MrSwirlyEyes/transmission_of_touch_vr/code/test_scripts_unity/Hand/Assets/VR Hands/Meshes/Textures/Tex_Hands_Color.png

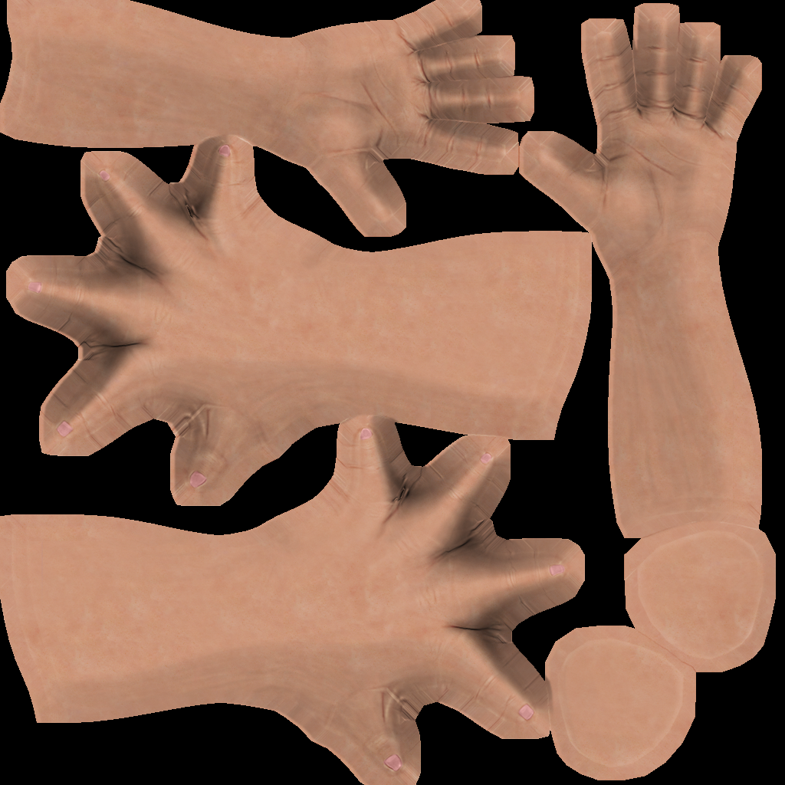
code/test_scripts_unity/Hand/Assets/VR Hands/Meshes/Textures/Tex_Hands_Color.png
