MrSwirlyEyes/transmission_of_touch_vr/doc/robotic_arm/schematic_force_sensitive_resistor_driver/schematic_force_sensitive_resistor_driver.png

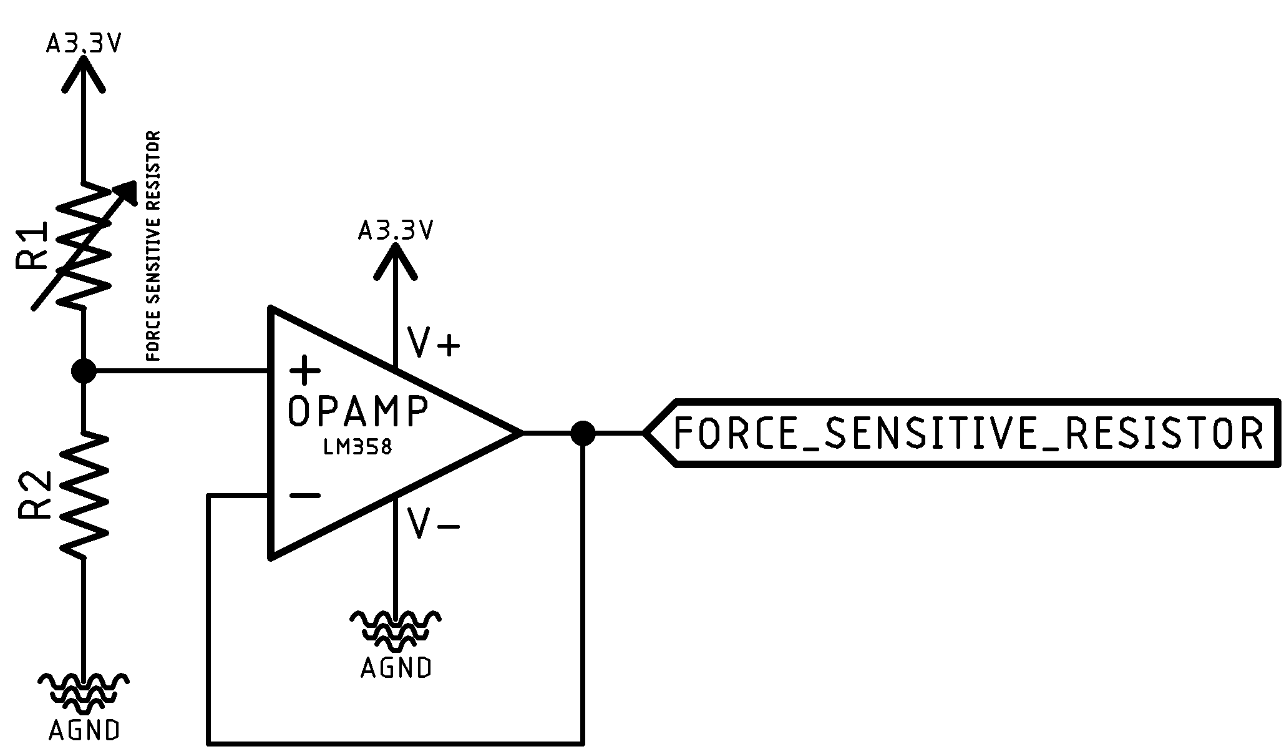
doc/robotic_arm/schematic_force_sensitive_resistor_driver/schematic_force_sensitive_resistor_driver.png
