MrSwirlyEyes/transmission_of_touch_vr/doc/robotic_arm/schematic_servo_driver/schematic_servo_driver.png

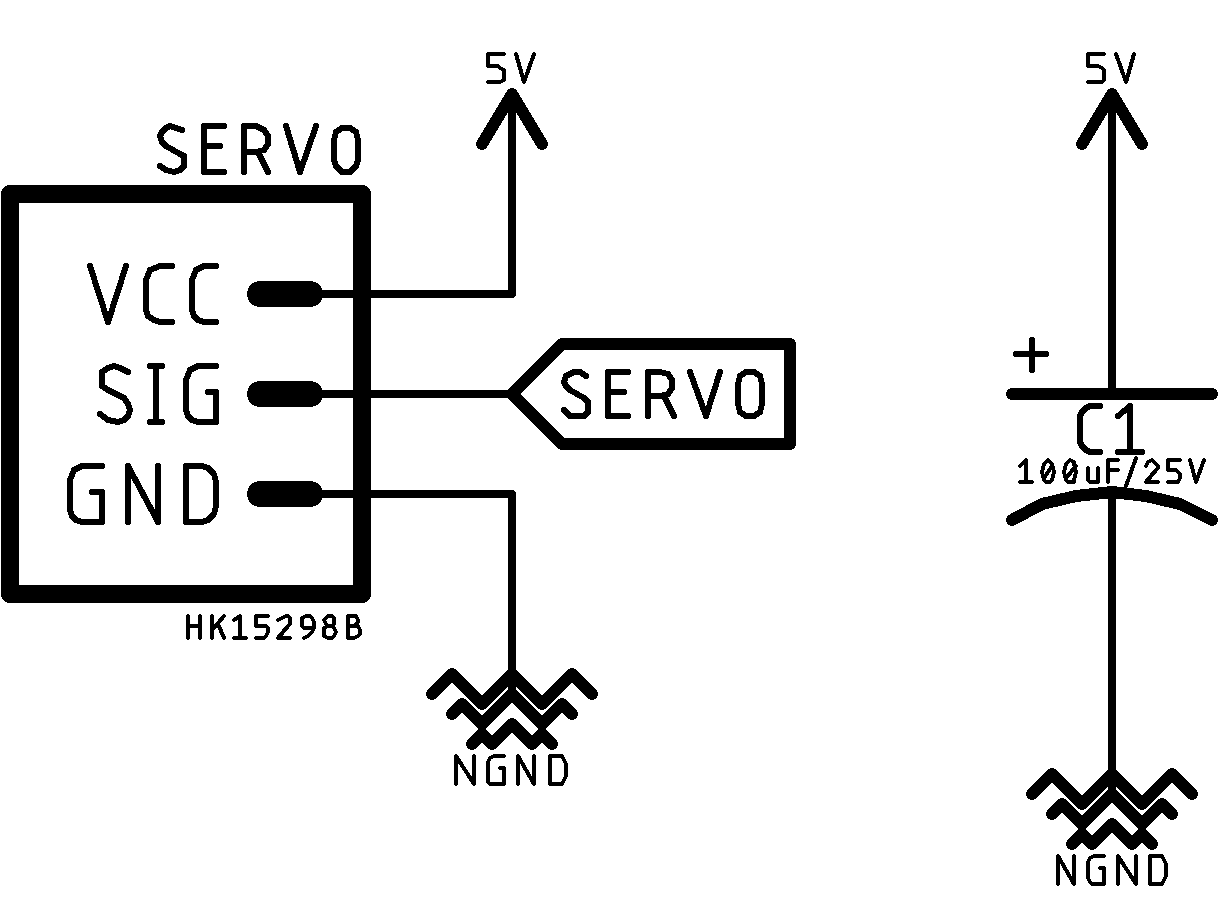
doc/robotic_arm/schematic_servo_driver/schematic_servo_driver.png
