MrSwirlyEyes/transmission_of_touch_vr/doc/robotic_arm/schematic_temperature_sensor_driver/schematic_temperature_sensor_driver.png

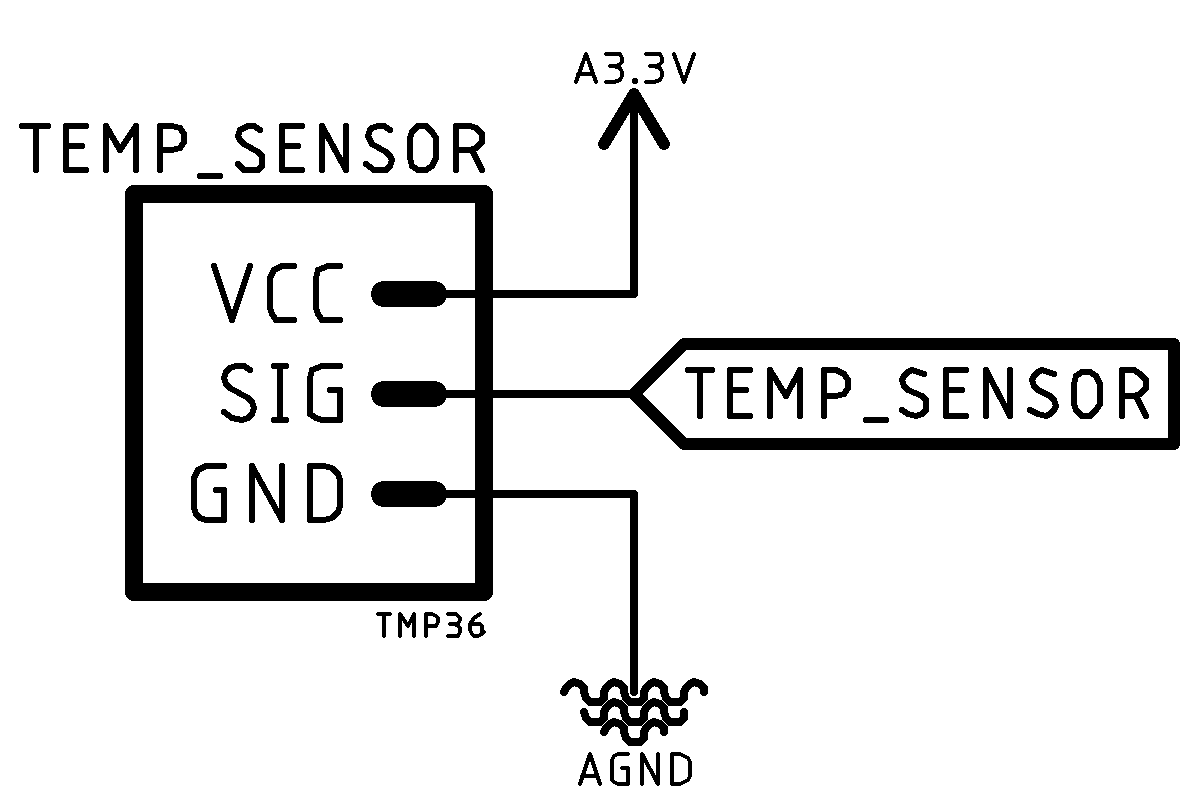
doc/robotic_arm/schematic_temperature_sensor_driver/schematic_temperature_sensor_driver.png
