MrSwirlyEyes/transmission_of_touch_vr/doc/touch_glove/schematic_flex_sensor_driver/schematic_flex_sensor_driver.png

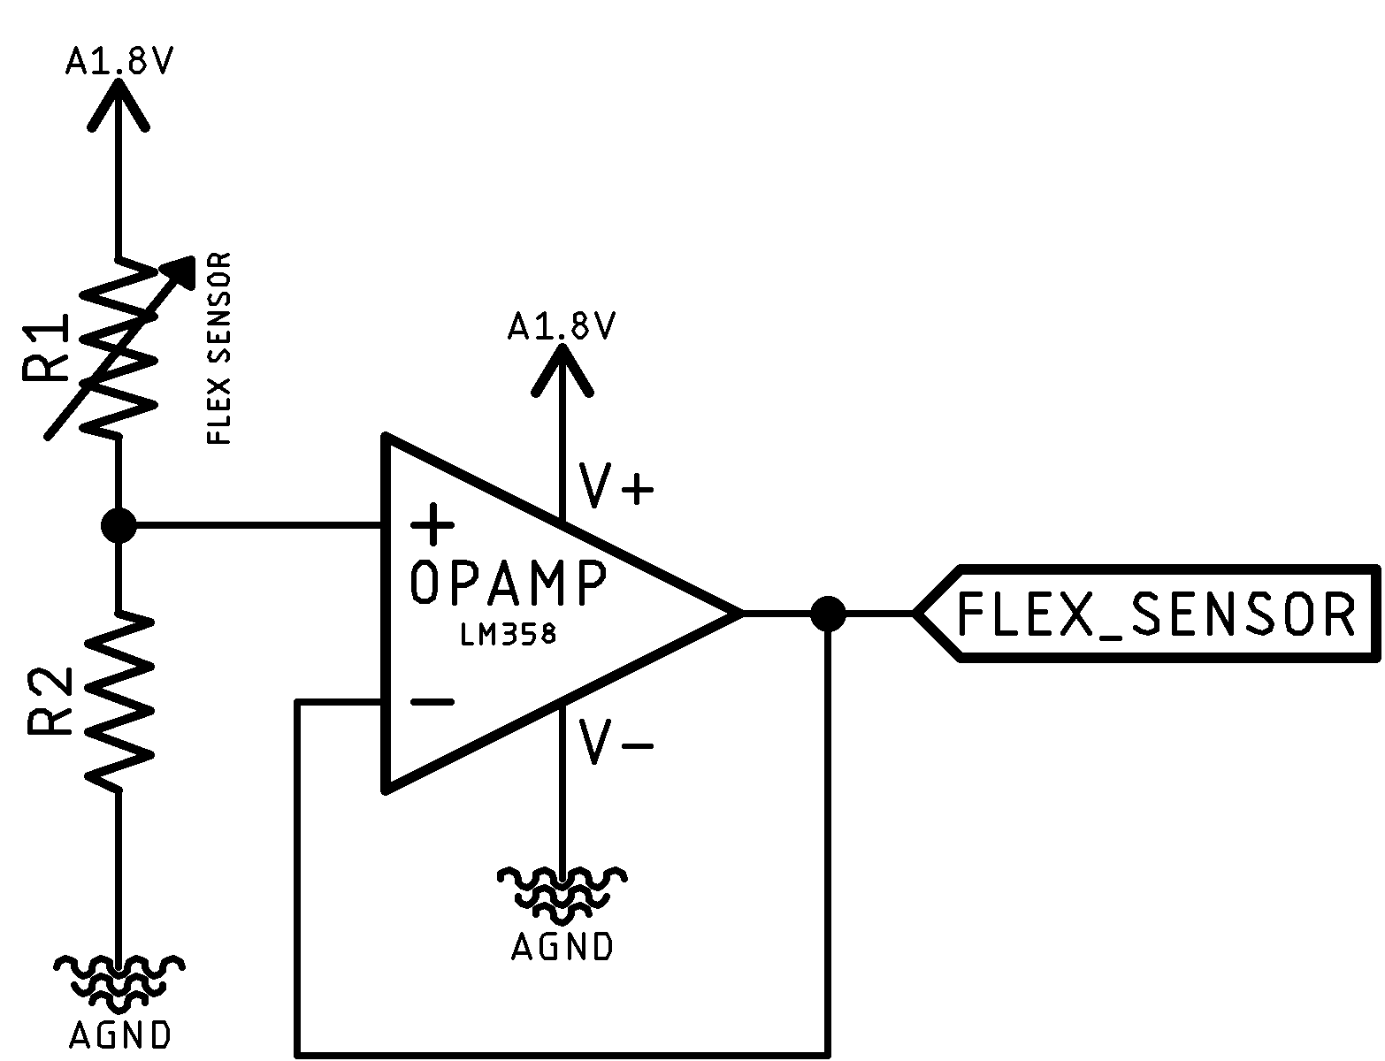
doc/touch_glove/schematic_flex_sensor_driver/schematic_flex_sensor_driver.png
