MrSwirlyEyes/transmission_of_touch_vr/doc/touch_glove/schematic_square_wave_oscillator/schematic_square_wave_oscillator.png

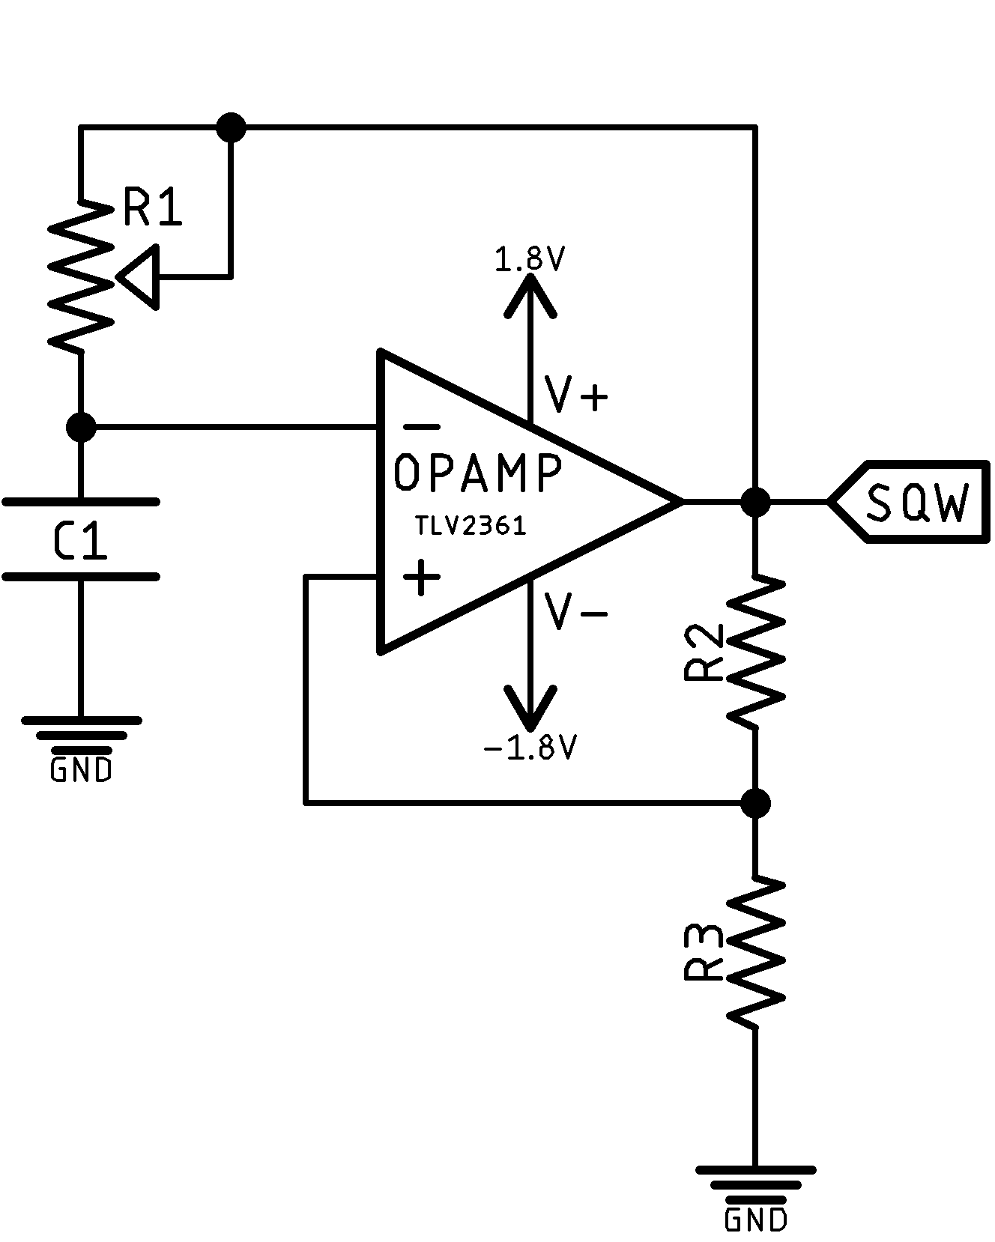
doc/touch_glove/schematic_square_wave_oscillator/schematic_square_wave_oscillator.png
