MrSwirlyEyes/transmission_of_touch_vr/doc/touch_glove/schematic_thermoelectric_driver/schematic_thermoelectric_driver.png

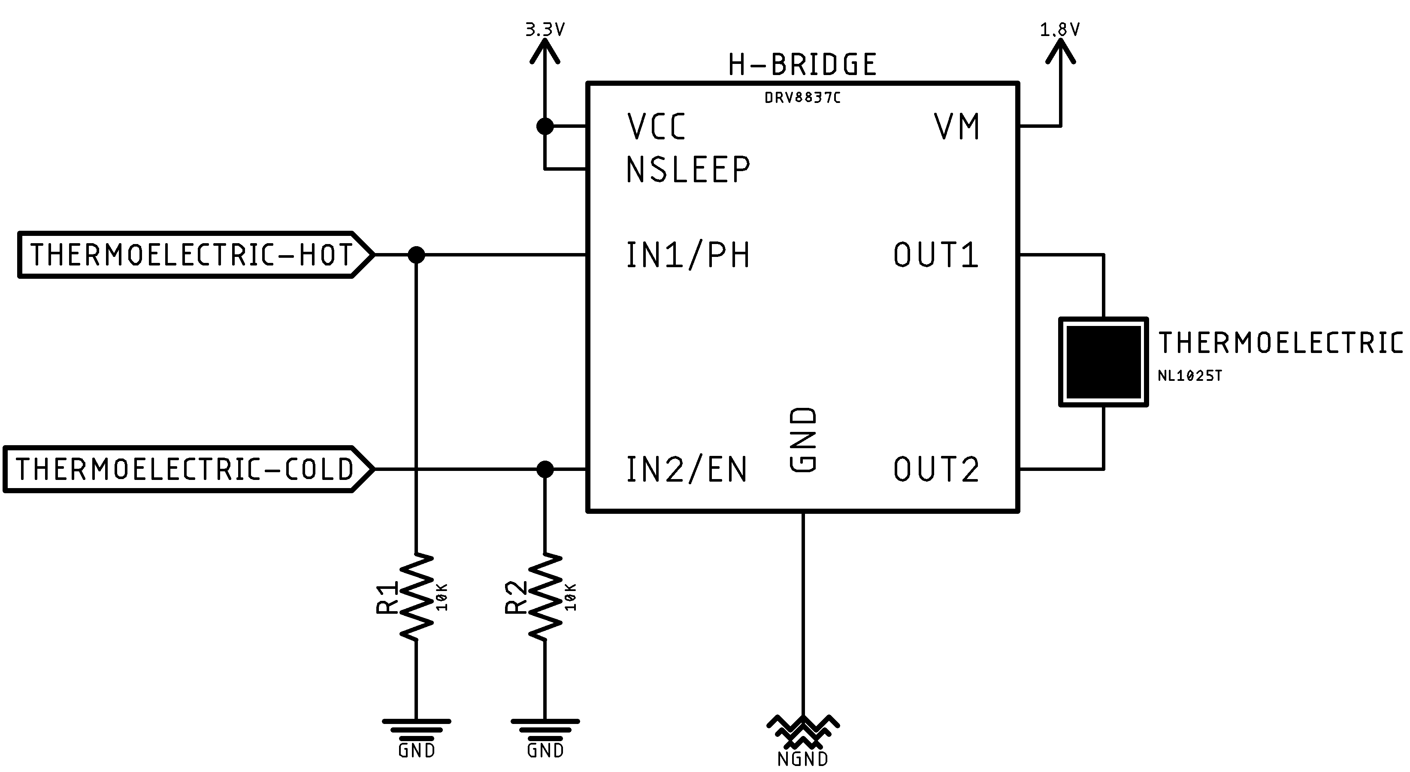
doc/touch_glove/schematic_thermoelectric_driver/schematic_thermoelectric_driver.png
