MrSwirlyEyes/transmission_of_touch_vr/doc/touch_glove/schematic_vibrotactile_driver/schematic_vibrotactile_driver.png

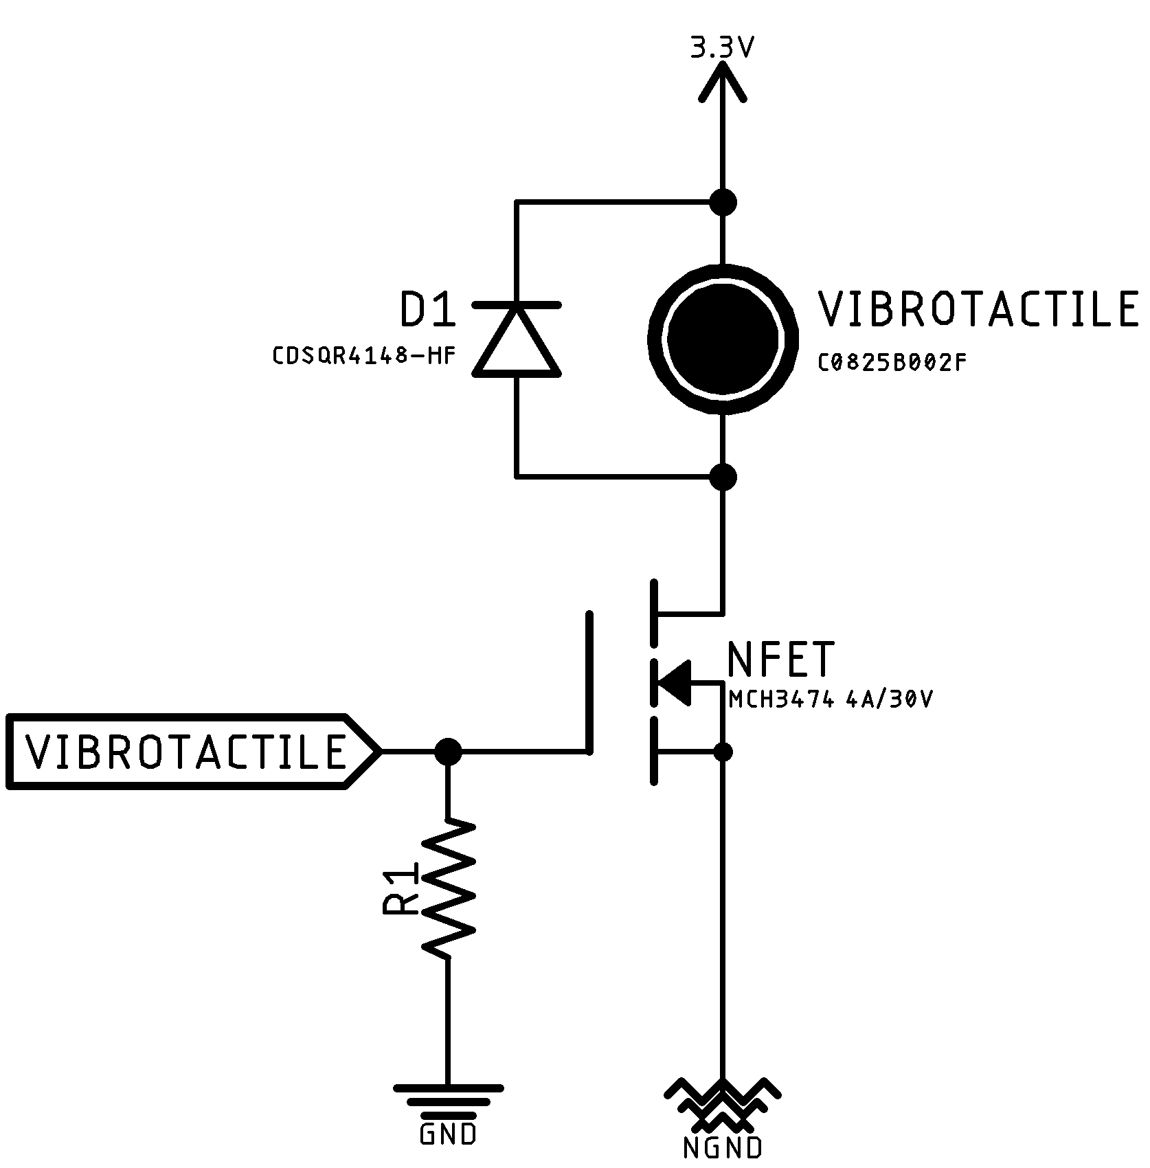
doc/touch_glove/schematic_vibrotactile_driver/schematic_vibrotactile_driver.png
