MrSwirlyEyes/transmission_of_touch_vr/ecad/electrotactile_extension/electrotactile_extension.brd

## EAGLE design ecad/electrotactile_extension/electrotactile_extension.brd (2019-05-16)

Schematic: electrotactile_extension.sch

Parts:
C37, C49, C63, C64, C66, C68, C69, C70, C76, C78, C80: 0.1uF/50V; CAPC1005X55_SMD-0402
C61: 0.1uF/50V; CAPC1608X95
C62: 0.1uF/250V/0805; CAPC2012X95_SMD-0805
C65: 100uF/10V; CAPCP3216X160
C71, C72, C73, C75, C77, C79: 10uF/6.3V; CAPC1005X55_SMD-0402
C74: 4.7uF/10V/0402; CAPC1005X55_SMD-0402
ET_INDEX_PIXEL1-1, ET_INDEX_PIXEL1-2, ET_INDEX_PIXEL1-3, ET_INDEX_PIXEL1-4, ET_INDEX_PIXEL2-1, ET_INDEX_PIXEL2-2, ET_INDEX_PIXEL2-3, ET_INDEX_PIXEL2-4, ET_INDEX_PIXEL3-1, ET_INDEX_PIXEL3-2, ET_INDEX_PIXEL3-3, ET_INDEX_PIXEL3-4, ET_INDEX_PIXEL4-1, ET_INDEX_PIXEL4-2, ET_INDEX_PIXEL4-3, ET_INDEX_PIXEL4-4: SPST-NO 170mA 250V; SOP254P609X203-4
ET_MIDDLE_PIXEL1-1, ET_MIDDLE_PIXEL1-2, ET_MIDDLE_PIXEL1-3, ET_MIDDLE_PIXEL1-4, ET_MIDDLE_PIXEL2-1, ET_MIDDLE_PIXEL2-2, ET_MIDDLE_PIXEL2-3, ET_MIDDLE_PIXEL2-4, ET_MIDDLE_PIXEL3-1, ET_MIDDLE_PIXEL3-2, ET_MIDDLE_PIXEL3-3, ET_MIDDLE_PIXEL3-4, ET_MIDDLE_PIXEL4-1, ET_MIDDLE_PIXEL4-2, ET_MIDDLE_PIXEL4-3, ET_MIDDLE_PIXEL4-4: SPST-NO 170mA 250V; SOP254P609X203-4
ET_PINKY_PIXEL1-1, ET_PINKY_PIXEL1-2, ET_PINKY_PIXEL1-3, ET_PINKY_PIXEL1-4, ET_PINKY_PIXEL2-1, ET_PINKY_PIXEL2-2, ET_PINKY_PIXEL2-3, ET_PINKY_PIXEL2-4, ET_PINKY_PIXEL3-1, ET_PINKY_PIXEL3-2, ET_PINKY_PIXEL3-3, ET_PINKY_PIXEL3-4, ET_PINKY_PIXEL4-1, ET_PINKY_PIXEL4-2, ET_PINKY_PIXEL4-3, ET_PINKY_PIXEL4-4: SPST-NO 170mA 250V; SOP254P609X203-4
ET_RING_PIXEL1-1, ET_RING_PIXEL1-2, ET_RING_PIXEL1-3, ET_RING_PIXEL1-4, ET_RING_PIXEL2-1, ET_RING_PIXEL2-2, ET_RING_PIXEL2-3, ET_RING_PIXEL2-4, ET_RING_PIXEL3-1, ET_RING_PIXEL3-2, ET_RING_PIXEL3-3, ET_RING_PIXEL3-4, ET_RING_PIXEL4-1, ET_RING_PIXEL4-2, ET_RING_PIXEL4-3, ET_RING_PIXEL4-4: SPST-NO 170mA 250V; SOP254P609X203-4
IC1: DRV8662; QFN50P400X400X100-21T270
INDEX_CONNECTOR: 1x17 MOLEX SMD RA; 1X17_MOLEX_0532611771_RA_SMD
J6, J7, J8, J9: 1x02 PTH VERT FEMALE; HDRVR2W64P254_1X2_558X254X850B
L3: 4.7uH/2A/1008; INDC2520X100
L4: 10uH/380mA; INDC1608X60-0603
MIDDLE_CONNECTOR: 1x17 MOLEX SMD RA; 1X17_MOLEX_0532611771_RA_SMD
MUX_INDEX: PCA9685; SOP65P650X110-28
MUX_MIDDLE: PCA9685; SOP65P650X110-28
MUX_PINKY: PCA9685; SOP65P650X110-28
MUX_RING: PCA9685; SOP65P650X110-28
NFET1: 2N7002DW; SOT65P230X110-6
OPAMP4: TLV2361_GP_20MA_7MHZ; SOT95P280X145-5
PINKY_CONNECTOR: 1x17 MOLEX SMD RA; 1X17_MOLEX_0532611771_RA_SMD
POT1: 100K; POTENTIOMETER_SQ-L5-W4.5-H2.3
R1: 768K; RESC1005X35_SMD-0402
R2: 115K; RESC1005X35_SMD-0402
R4: 220K; RESC1005X35_SMD-0402
R5: 100K; RESC1005X35_SMD-0402
R49, R57, R58, R59, R60, R61, R62, R63, R64, R65, R66, R67, R68, R69, R70, R71, R88, R89, R90, R91, R92, R93, R94, R95, R96, R97, R98, R99, R100, R101, R102, R103, R104, R105, R106, R107, R108, R109, R110, R111, R112, R113, R114, R115, R116, R117, R118, R119, R120, R121, R122, R123, R124, R125, R126, R127, R128, R129, R130, R131, R132, R133, R134, R135: 1K; RESC1005X35_SMD-0402
R54, R55, R56, R136, R137: 10K; RESC1005X35_SMD-0402
REXT: 7.5K; RESC1005X35_SMD-0402
RING_CONNECTOR: 1x17 MOLEX SMD RA; 1X17_MOLEX_0532611771_RA_SMD
SW1, SW3, SW4: 300mA/4V; SW_SLIDE_SPDT_RA_SMD_4V_300MA_6.7L-2.6W
VREG2: NCP1729 50mA; SOT95P275X100-6
VREG3: TPS62202 300mA 1.8V; SOT95P280X145-5
VREG-MCU1: TPS76833QDR 1A/3.3V; SOIC127P600X265-8

Connections:
1.8V: C73.1, C75.1, L4.2, OPAMP4.5 (V+), VREG2.2 (VIN), VREG2.5 (!SHDN), VREG3.4 (NC/FB)
3.3V: C37.1, C61.1, C65.A, C66.1, C68.1, C69.1, C70.1, C74.1, C77.1, C78.1, IC1.2 (VDD), L3.2, MUX_INDEX.2 (A1), MUX_INDEX.28 (VCC), MUX_MIDDLE.1 (A0), MUX_MIDDLE.2 (A1), MUX_MIDDLE.28 (VCC), MUX_PINKY.1 (A0), MUX_PINKY.3 (A2), MUX_PINKY.28 (VCC), MUX_RING.3 (A2), MUX_RING.28 (VCC), SW1.2, SW3.2, SW4.2, VREG3.1 (VIN), VREG3.3 (EN), VREG-MCU1.5 (VOUT), VREG-MCU1.6 (VOUT)
-1.8V: C72.1, OPAMP4.2 (V-), VREG2.1 (VOUT)
C+: C71.1, VREG2.6 (C+)
C-: C71.2, VREG2.3 (C-)
EN: IC1.20 (EN), R54.2, SW1.3 (S2)
FB: IC1.3 (FB), R1.1, R2.2, R4.2, R5.2
GAIN0: IC1.18 (GAIN0), NFET1.5 (G2), R55.2, SW3.3 (S2)
GAIN1: IC1.19 (GAIN1), NFET1.2 (G1), R56.2, SW4.3 (S2)
GND: C37.2, C49.2, C61.2, C62.2, C63.1, C65.K, C66.2, C68.2, C69.2, C70.2, C72.2, C73.2, C74.2, C75.2, C76.2, C77.2, C78.2, C79.2, C80.2, IC1.4 (GND), IC1.5 (GND), IC1.6 (GND), IC1.9 (GND), IC1.EP (GND), IC1.P$1 (GND), IC1.P$2 (GND), IC1.P$3 (GND), IC1.P$4 (GND), J6.2, MUX_INDEX.1 (A0), MUX_INDEX.3 (A2), MUX_INDEX.4 (A3), MUX_INDEX.5 (A4), MUX_INDEX.14 (GND), MUX_INDEX.23 (!OE), MUX_INDEX.24 (A5), MUX_INDEX.25 (EXTCLK), MUX_MIDDLE.3 (A2), MUX_MIDDLE.4 (A3), MUX_MIDDLE.5 (A4), MUX_MIDDLE.14 (GND), MUX_MIDDLE.23 (!OE), MUX_MIDDLE.24 (A5), MUX_MIDDLE.25 (EXTCLK), MUX_PINKY.2 (A1), MUX_PINKY.4 (A3), MUX_PINKY.5 (A4), MUX_PINKY.14 (GND), MUX_PINKY.23 (!OE), MUX_PINKY.24 (A5), MUX_PINKY.25 (EXTCLK), MUX_RING.1 (A0), MUX_RING.2 (A1), MUX_RING.4 (A3), MUX_RING.5 (A4), MUX_RING.14 (GND), MUX_RING.23 (!OE), MUX_RING.24 (A5), MUX_RING.25 (EXTCLK), NFET1.1 (S1), NFET1.4 (S2), R2.1, R49.1, R54.1, R55.1, R56.1, R57.1, R58.1, R59.1, R60.1, R61.1, R62.1, R63.1, R64.1, R65.1, R66.1, R67.1, R68.1, R69.1, R70.1, R71.1, R88.1, R89.1, R90.1, R91.1, R92.1, R93.1, R94.1, R95.1, R96.1, R97.1, R98.1, R99.1, R100.1, R101.1, R102.1, R103.1, R104.1, R105.1, R106.1, R107.1, R108.1, R109.1, R110.1, R111.1, R112.1, R113.1, R114.1, R115.1, R116.1, R117.1, R118.1, R119.1, R120.1, R121.1, R122.1, R123.1, R124.1, R125.1, R126.1, R127.1, R128.1, R129.1, R130.1, R131.1, R132.1, R133.1, R134.1, R135.1, R137.1, REXT.1, VREG2.4 (GND), VREG3.2 (GND), VREG-MCU1.1 (GND), VREG-MCU1.2 (!EN)
IN+: C64.1, OPAMP4.4 (OUT), POT1.1 (CCW), POT1.2 (S), R136.2
INDEX_IN1-1: ET_INDEX_PIXEL1-1.1, MUX_INDEX.6 (PWM0)
INDEX_IN1-2: ET_INDEX_PIXEL1-2.1, MUX_INDEX.8 (PWM2)
INDEX_IN1-3: ET_INDEX_PIXEL1-3.1, MUX_INDEX.10 (PWM4)
INDEX_IN1-4: ET_INDEX_PIXEL1-4.1, MUX_INDEX.12 (PWM6)
INDEX_IN2-1: ET_INDEX_PIXEL2-1.1, MUX_INDEX.7 (PWM1)
INDEX_IN2-2: ET_INDEX_PIXEL2-2.1, MUX_INDEX.9 (PWM3)
INDEX_IN2-3: ET_INDEX_PIXEL2-3.1, MUX_INDEX.11 (PWM5)
INDEX_IN2-4: ET_INDEX_PIXEL2-4.1, MUX_INDEX.13 (PWM7)
INDEX_IN3-1: ET_INDEX_PIXEL3-1.1, MUX_INDEX.15 (PWM8)
INDEX_IN3-2: ET_INDEX_PIXEL3-2.1, MUX_INDEX.17 (PWM10)
INDEX_IN3-3: ET_INDEX_PIXEL3-3.1, MUX_INDEX.19 (PWM12)
INDEX_IN3-4: ET_INDEX_PIXEL3-4.1, MUX_INDEX.21 (PWM14)
INDEX_IN4-1: ET_INDEX_PIXEL4-1.1, MUX_INDEX.16 (PWM9)
INDEX_IN4-2: ET_INDEX_PIXEL4-2.1, MUX_INDEX.18 (PWM11)
INDEX_IN4-3: ET_INDEX_PIXEL4-3.1, MUX_INDEX.20 (PWM13)
INDEX_IN4-4: ET_INDEX_PIXEL4-4.1, MUX_INDEX.22 (PWM15)
INDEX_OUT1-1: ET_INDEX_PIXEL1-1.3, INDEX_CONNECTOR.1
INDEX_OUT1-2: ET_INDEX_PIXEL1-2.3, INDEX_CONNECTOR.3
INDEX_OUT1-3: ET_INDEX_PIXEL1-3.3, INDEX_CONNECTOR.5
INDEX_OUT1-4: ET_INDEX_PIXEL1-4.3, INDEX_CONNECTOR.7
INDEX_OUT2-1: ET_INDEX_PIXEL2-1.3, INDEX_CONNECTOR.2
INDEX_OUT2-2: ET_INDEX_PIXEL2-2.3, INDEX_CONNECTOR.4
INDEX_OUT2-3: ET_INDEX_PIXEL2-3.3, INDEX_CONNECTOR.6
INDEX_OUT2-4: ET_INDEX_PIXEL2-4.3, INDEX_CONNECTOR.8
INDEX_OUT3-1: ET_INDEX_PIXEL3-1.3, INDEX_CONNECTOR.9
INDEX_OUT3-2: ET_INDEX_PIXEL3-2.3, INDEX_CONNECTOR.11
INDEX_OUT3-3: ET_INDEX_PIXEL3-3.3, INDEX_CONNECTOR.13
INDEX_OUT3-4: ET_INDEX_PIXEL3-4.3, INDEX_CONNECTOR.15
INDEX_OUT4-1: ET_INDEX_PIXEL4-1.3, INDEX_CONNECTOR.10
INDEX_OUT4-2: ET_INDEX_PIXEL4-2.3, INDEX_CONNECTOR.12
INDEX_OUT4-3: ET_INDEX_PIXEL4-3.3, INDEX_CONNECTOR.14
INDEX_OUT4-4: ET_INDEX_PIXEL4-4.3, INDEX_CONNECTOR.16
MIDDLE_IN1-1: ET_MIDDLE_PIXEL1-1.1, MUX_MIDDLE.21 (PWM14)
MIDDLE_IN1-2: ET_MIDDLE_PIXEL1-2.1, MUX_MIDDLE.19 (PWM12)
MIDDLE_IN1-3: ET_MIDDLE_PIXEL1-3.1, MUX_MIDDLE.17 (PWM10)
MIDDLE_IN1-4: ET_MIDDLE_PIXEL1-4.1, MUX_MIDDLE.15 (PWM8)
MIDDLE_IN2-1: ET_MIDDLE_PIXEL2-1.1, MUX_MIDDLE.22 (PWM15)
MIDDLE_IN2-2: ET_MIDDLE_PIXEL2-2.1, MUX_MIDDLE.20 (PWM13)
MIDDLE_IN2-3: ET_MIDDLE_PIXEL2-3.1, MUX_MIDDLE.18 (PWM11)
MIDDLE_IN2-4: ET_MIDDLE_PIXEL2-4.1, MUX_MIDDLE.16 (PWM9)
MIDDLE_IN3-1: ET_MIDDLE_PIXEL3-1.1, MUX_MIDDLE.12 (PWM6)
MIDDLE_IN3-2: ET_MIDDLE_PIXEL3-2.1, MUX_MIDDLE.10 (PWM4)
MIDDLE_IN3-3: ET_MIDDLE_PIXEL3-3.1, MUX_MIDDLE.8 (PWM2)
MIDDLE_IN3-4: ET_MIDDLE_PIXEL3-4.1, MUX_MIDDLE.6 (PWM0)
MIDDLE_IN4-1: ET_MIDDLE_PIXEL4-1.1, MUX_MIDDLE.13 (PWM7)
MIDDLE_IN4-2: ET_MIDDLE_PIXEL4-2.1, MUX_MIDDLE.11 (PWM5)
MIDDLE_IN4-3: ET_MIDDLE_PIXEL4-3.1, MUX_MIDDLE.9 (PWM3)
MIDDLE_IN4-4: ET_MIDDLE_PIXEL4-4.1, MUX_MIDDLE.7 (PWM1)
MIDDLE_OUT1-1: ET_MIDDLE_PIXEL1-1.3, MIDDLE_CONNECTOR.16
MIDDLE_OUT1-2: ET_MIDDLE_PIXEL1-2.3, MIDDLE_CONNECTOR.14
MIDDLE_OUT1-3: ET_MIDDLE_PIXEL1-3.3, MIDDLE_CONNECTOR.12
MIDDLE_OUT1-4: ET_MIDDLE_PIXEL1-4.3, MIDDLE_CONNECTOR.10
MIDDLE_OUT2-1: ET_MIDDLE_PIXEL2-1.3, MIDDLE_CONNECTOR.17
MIDDLE_OUT2-2: ET_MIDDLE_PIXEL2-2.3, MIDDLE_CONNECTOR.15
MIDDLE_OUT2-3: ET_MIDDLE_PIXEL2-3.3, MIDDLE_CONNECTOR.13
MIDDLE_OUT2-4: ET_MIDDLE_PIXEL2-4.3, MIDDLE_CONNECTOR.11
MIDDLE_OUT3-1: ET_MIDDLE_PIXEL3-1.3, MIDDLE_CONNECTOR.8
MIDDLE_OUT3-2: ET_MIDDLE_PIXEL3-2.3, MIDDLE_CONNECTOR.6
MIDDLE_OUT3-3: ET_MIDDLE_PIXEL3-3.3, MIDDLE_CONNECTOR.4
MIDDLE_OUT3-4: ET_MIDDLE_PIXEL3-4.3, MIDDLE_CONNECTOR.2
MIDDLE_OUT4-1: ET_MIDDLE_PIXEL4-1.3, MIDDLE_CONNECTOR.9
MIDDLE_OUT4-2: ET_MIDDLE_PIXEL4-2.3, MIDDLE_CONNECTOR.7
MIDDLE_OUT4-3: ET_MIDDLE_PIXEL4-3.3, MIDDLE_CONNECTOR.5
MIDDLE_OUT4-4: ET_MIDDLE_PIXEL4-4.3, MIDDLE_CONNECTOR.3
unnamed: ET_INDEX_PIXEL1-3.2, R58.2
unnamed: ET_INDEX_PIXEL1-1.2, R49.2
unnamed: IC1.7 (SW), IC1.8 (SW), L3.1
unnamed: C49.1, IC1.1 (VPUMP)
unnamed: C62.1, IC1.10 (VBST), IC1.11 (VBST), IC1.12 (PVDD), R1.2
unnamed: IC1.15 (REXT), REXT.2
unnamed: NFET1.6 (D1), R4.1
unnamed: NFET1.3 (D2), R5.1
unnamed: C64.2, IC1.17 (IN+)
unnamed: C63.2, IC1.16 (IN-)
unnamed: ET_INDEX_PIXEL1-2.2, R57.2
unnamed: ET_INDEX_PIXEL1-4.2, R59.2
unnamed: ET_INDEX_PIXEL2-1.2, R60.2
unnamed: ET_INDEX_PIXEL2-2.2, R61.2
unnamed: ET_INDEX_PIXEL2-3.2, R62.2
unnamed: ET_INDEX_PIXEL2-4.2, R63.2
unnamed: ET_INDEX_PIXEL3-1.2, R64.2
unnamed: ET_INDEX_PIXEL3-2.2, R65.2
unnamed: ET_INDEX_PIXEL3-3.2, R66.2
unnamed: ET_INDEX_PIXEL3-4.2, R67.2
unnamed: ET_INDEX_PIXEL4-1.2, R68.2
unnamed: ET_INDEX_PIXEL4-2.2, R69.2
unnamed: ET_INDEX_PIXEL4-3.2, R70.2
unnamed: ET_INDEX_PIXEL4-4.2, R71.2
unnamed: ET_MIDDLE_PIXEL1-1.2, R88.2
unnamed: ET_MIDDLE_PIXEL1-2.2, R89.2
unnamed: ET_MIDDLE_PIXEL1-3.2, R90.2
unnamed: ET_MIDDLE_PIXEL1-4.2, R91.2
unnamed: ET_MIDDLE_PIXEL2-1.2, R92.2
unnamed: ET_MIDDLE_PIXEL2-2.2, R93.2
unnamed: ET_MIDDLE_PIXEL2-3.2, R94.2
unnamed: ET_MIDDLE_PIXEL2-4.2, R95.2
unnamed: ET_MIDDLE_PIXEL3-1.2, R96.2
unnamed: ET_MIDDLE_PIXEL3-2.2, R97.2
unnamed: ET_MIDDLE_PIXEL3-3.2, R98.2
unnamed: ET_MIDDLE_PIXEL3-4.2, R99.2
unnamed: ET_MIDDLE_PIXEL4-1.2, R100.2
unnamed: ET_MIDDLE_PIXEL4-2.2, R101.2
unnamed: ET_MIDDLE_PIXEL4-3.2, R102.2
unnamed: ET_MIDDLE_PIXEL4-4.2, R103.2
unnamed: ET_RING_PIXEL1-1.2, R104.2
unnamed: ET_RING_PIXEL1-2.2, R105.2
unnamed: ET_RING_PIXEL1-3.2, R106.2
unnamed: ET_RING_PIXEL1-4.2, R107.2
unnamed: ET_RING_PIXEL2-1.2, R108.2
unnamed: ET_RING_PIXEL2-2.2, R109.2
unnamed: ET_RING_PIXEL2-3.2, R110.2
unnamed: ET_RING_PIXEL2-4.2, R111.2
unnamed: ET_RING_PIXEL3-1.2, R112.2
unnamed: ET_RING_PIXEL3-2.2, R113.2
unnamed: ET_RING_PIXEL3-3.2, R114.2
unnamed: ET_RING_PIXEL3-4.2, R115.2
unnamed: ET_RING_PIXEL4-1.2, R116.2
unnamed: ET_RING_PIXEL4-2.2, R117.2
unnamed: ET_RING_PIXEL4-3.2, R118.2
unnamed: ET_RING_PIXEL4-4.2, R119.2
unnamed: ET_PINKY_PIXEL1-1.2, R120.2
unnamed: ET_PINKY_PIXEL1-2.2, R121.2
unnamed: ET_PINKY_PIXEL1-3.2, R122.2
unnamed: ET_PINKY_PIXEL1-4.2, R123.2
unnamed: ET_PINKY_PIXEL2-1.2, R124.2
unnamed: ET_PINKY_PIXEL2-2.2, R125.2
unnamed: ET_PINKY_PIXEL2-3.2, R126.2
unnamed: ET_PINKY_PIXEL2-4.2, R127.2
unnamed: ET_PINKY_PIXEL3-1.2, R128.2
unnamed: ET_PINKY_PIXEL3-2.2, R129.2
unnamed: ET_PINKY_PIXEL3-3.2, R130.2
unnamed: ET_PINKY_PIXEL3-4.2, R131.2
unnamed: ET_PINKY_PIXEL4-1.2, R132.2
unnamed: ET_PINKY_PIXEL4-2.2, R133.2
unnamed: ET_PINKY_PIXEL4-3.2, R134.2
unnamed: ET_PINKY_PIXEL4-4.2, R135.2
unnamed: L4.1, VREG3.5 (VOUT)
unnamed: OPAMP4.1 (IN+), R136.1, R137.2
unnamed: C76.1, OPAMP4.3 (IN-), POT1.3 (CW)
PINKY_IN1-1: ET_PINKY_PIXEL1-1.1, MUX_PINKY.22 (PWM15)
PINKY_IN1-2: ET_PINKY_PIXEL1-2.1, MUX_PINKY.20 (PWM13)
PINKY_IN1-3: ET_PINKY_PIXEL1-3.1, MUX_PINKY.18 (PWM11)
PINKY_IN1-4: ET_PINKY_PIXEL1-4.1, MUX_PINKY.16 (PWM9)
PINKY_IN2-1: ET_PINKY_PIXEL2-1.1, MUX_PINKY.21 (PWM14)
PINKY_IN2-2: ET_PINKY_PIXEL2-2.1, MUX_PINKY.19 (PWM12)
PINKY_IN2-3: ET_PINKY_PIXEL2-3.1, MUX_PINKY.17 (PWM10)
PINKY_IN2-4: ET_PINKY_PIXEL2-4.1, MUX_PINKY.15 (PWM8)
PINKY_IN3-1: ET_PINKY_PIXEL3-1.1, MUX_PINKY.13 (PWM7)
PINKY_IN3-2: ET_PINKY_PIXEL3-2.1, MUX_PINKY.11 (PWM5)
PINKY_IN3-3: ET_PINKY_PIXEL3-3.1, MUX_PINKY.9 (PWM3)
PINKY_IN3-4: ET_PINKY_PIXEL3-4.1, MUX_PINKY.7 (PWM1)
PINKY_IN4-1: ET_PINKY_PIXEL4-1.1, MUX_PINKY.12 (PWM6)
PINKY_IN4-2: ET_PINKY_PIXEL4-2.1, MUX_PINKY.10 (PWM4)
PINKY_IN4-3: ET_PINKY_PIXEL4-3.1, MUX_PINKY.8 (PWM2)
PINKY_IN4-4: ET_PINKY_PIXEL4-4.1, MUX_PINKY.6 (PWM0)
PINKY_OUT1-1: ET_PINKY_PIXEL1-1.3, PINKY_CONNECTOR.16
PINKY_OUT1-2: ET_PINKY_PIXEL1-2.3, PINKY_CONNECTOR.14
PINKY_OUT1-3: ET_PINKY_PIXEL1-3.3, PINKY_CONNECTOR.12
PINKY_OUT1-4: ET_PINKY_PIXEL1-4.3, PINKY_CONNECTOR.10
PINKY_OUT2-1: ET_PINKY_PIXEL2-1.3, PINKY_CONNECTOR.17
PINKY_OUT2-2: ET_PINKY_PIXEL2-2.3, PINKY_CONNECTOR.15
PINKY_OUT2-3: ET_PINKY_PIXEL2-3.3, PINKY_CONNECTOR.13
PINKY_OUT2-4: ET_PINKY_PIXEL2-4.3, PINKY_CONNECTOR.11
PINKY_OUT3-1: ET_PINKY_PIXEL3-1.3, PINKY_CONNECTOR.8
PINKY_OUT3-2: ET_PINKY_PIXEL3-2.3, PINKY_CONNECTOR.6
PINKY_OUT3-3: ET_PINKY_PIXEL3-3.3, PINKY_CONNECTOR.4
PINKY_OUT3-4: ET_PINKY_PIXEL3-4.3, PINKY_CONNECTOR.2
PINKY_OUT4-1: ET_PINKY_PIXEL4-1.3, PINKY_CONNECTOR.9
PINKY_OUT4-2: ET_PINKY_PIXEL4-2.3, PINKY_CONNECTOR.7
PINKY_OUT4-3: ET_PINKY_PIXEL4-3.3, PINKY_CONNECTOR.5
PINKY_OUT4-4: ET_PINKY_PIXEL4-4.3, PINKY_CONNECTOR.3
RING_IN1-1: ET_RING_PIXEL1-1.1, MUX_RING.7 (PWM1)
RING_IN1-2: ET_RING_PIXEL1-2.1, MUX_RING.9 (PWM3)
RING_IN1-3: ET_RING_PIXEL1-3.1, MUX_RING.11 (PWM5)
RING_IN1-4: ET_RING_PIXEL1-4.1, MUX_RING.13 (PWM7)
RING_IN2-1: ET_RING_PIXEL2-1.1, MUX_RING.6 (PWM0)
RING_IN2-2: ET_RING_PIXEL2-2.1, MUX_RING.8 (PWM2)
RING_IN2-3: ET_RING_PIXEL2-3.1, MUX_RING.10 (PWM4)
RING_IN2-4: ET_RING_PIXEL2-4.1, MUX_RING.12 (PWM6)
RING_IN3-1: ET_RING_PIXEL3-1.1, MUX_RING.16 (PWM9)
RING_IN3-2: ET_RING_PIXEL3-2.1, MUX_RING.18 (PWM11)
RING_IN3-3: ET_RING_PIXEL3-3.1, MUX_RING.20 (PWM13)
RING_IN3-4: ET_RING_PIXEL3-4.1, MUX_RING.22 (PWM15)
RING_IN4-1: ET_RING_PIXEL4-1.1, MUX_RING.15 (PWM8)
RING_IN4-2: ET_RING_PIXEL4-2.1, MUX_RING.17 (PWM10)
RING_IN4-3: ET_RING_PIXEL4-3.1, MUX_RING.19 (PWM12)
RING_IN4-4: ET_RING_PIXEL4-4.1, MUX_RING.21 (PWM14)
RING_OUT1-1: ET_RING_PIXEL1-1.3, RING_CONNECTOR.1
RING_OUT1-2: ET_RING_PIXEL1-2.3, RING_CONNECTOR.3
RING_OUT1-3: ET_RING_PIXEL1-3.3, RING_CONNECTOR.5
RING_OUT1-4: ET_RING_PIXEL1-4.3, RING_CONNECTOR.7
RING_OUT2-1: ET_RING_PIXEL2-1.3, RING_CONNECTOR.2
RING_OUT2-2: ET_RING_PIXEL2-2.3, RING_CONNECTOR.4
RING_OUT2-3: ET_RING_PIXEL2-3.3, RING_CONNECTOR.6
RING_OUT2-4: ET_RING_PIXEL2-4.3, RING_CONNECTOR.8
RING_OUT3-1: ET_RING_PIXEL3-1.3, RING_CONNECTOR.9
RING_OUT3-2: ET_RING_PIXEL3-2.3, RING_CONNECTOR.11
RING_OUT3-3: ET_RING_PIXEL3-3.3, RING_CONNECTOR.13
RING_OUT3-4: ET_RING_PIXEL3-4.3, RING_CONNECTOR.15
RING_OUT4-1: ET_RING_PIXEL4-1.3, RING_CONNECTOR.10
RING_OUT4-2: ET_RING_PIXEL4-2.3, RING_CONNECTOR.12
RING_OUT4-3: ET_RING_PIXEL4-3.3, RING_CONNECTOR.14
RING_OUT4-4: ET_RING_PIXEL4-4.3, RING_CONNECTOR.16
SCL: J7.2, MUX_INDEX.26 (SCL), MUX_MIDDLE.26 (SCL), MUX_PINKY.26 (SCL), MUX_RING.26 (SCL)
SDA: J7.1, MUX_INDEX.27 (SDA), MUX_MIDDLE.27 (SDA), MUX_PINKY.27 (SDA), MUX_RING.27 (SDA)
V+: ET_INDEX_PIXEL1-1.4, ET_INDEX_PIXEL1-2.4, ET_INDEX_PIXEL1-3.4, ET_INDEX_PIXEL1-4.4, ET_INDEX_PIXEL2-1.4, ET_INDEX_PIXEL2-2.4, ET_INDEX_PIXEL2-3.4, ET_INDEX_PIXEL2-4.4, ET_INDEX_PIXEL3-1.4, ET_INDEX_PIXEL3-2.4, ET_INDEX_PIXEL3-3.4, ET_INDEX_PIXEL3-4.4, ET_INDEX_PIXEL4-1.4, ET_INDEX_PIXEL4-2.4, ET_INDEX_PIXEL4-3.4, ET_INDEX_PIXEL4-4.4, ET_MIDDLE_PIXEL1-1.4, ET_MIDDLE_PIXEL1-2.4, ET_MIDDLE_PIXEL1-3.4, ET_MIDDLE_PIXEL1-4.4, ET_MIDDLE_PIXEL2-1.4, ET_MIDDLE_PIXEL2-2.4, ET_MIDDLE_PIXEL2-3.4, ET_MIDDLE_PIXEL2-4.4, ET_MIDDLE_PIXEL3-1.4, ET_MIDDLE_PIXEL3-2.4, ET_MIDDLE_PIXEL3-3.4, ET_MIDDLE_PIXEL3-4.4, ET_MIDDLE_PIXEL4-1.4, ET_MIDDLE_PIXEL4-2.4, ET_MIDDLE_PIXEL4-3.4, ET_MIDDLE_PIXEL4-4.4, ET_PINKY_PIXEL1-1.4, ET_PINKY_PIXEL1-2.4, ET_PINKY_PIXEL1-3.4, ET_PINKY_PIXEL1-4.4, ET_PINKY_PIXEL2-1.4, ET_PINKY_PIXEL2-2.4, ET_PINKY_PIXEL2-3.4, ET_PINKY_PIXEL2-4.4, ET_PINKY_PIXEL3-1.4, ET_PINKY_PIXEL3-2.4, ET_PINKY_PIXEL3-3.4, ET_PINKY_PIXEL3-4.4, ET_PINKY_PIXEL4-1.4, ET_PINKY_PIXEL4-2.4, ET_PINKY_PIXEL4-3.4, ET_PINKY_PIXEL4-4.4, ET_RING_PIXEL1-1.4, ET_RING_PIXEL1-2.4, ET_RING_PIXEL1-3.4, ET_RING_PIXEL1-4.4, ET_RING_PIXEL2-1.4, ET_RING_PIXEL2-2.4, ET_RING_PIXEL2-3.4, ET_RING_PIXEL2-4.4, ET_RING_PIXEL3-1.4, ET_RING_PIXEL3-2.4, ET_RING_PIXEL3-3.4, ET_RING_PIXEL3-4.4, ET_RING_PIXEL4-1.4, ET_RING_PIXEL4-2.4, ET_RING_PIXEL4-3.4, ET_RING_PIXEL4-4.4, IC1.13 (OUT+)
V-: IC1.14 (OUT-), INDEX_CONNECTOR.17, MIDDLE_CONNECTOR.1, PINKY_CONNECTOR.1, RING_CONNECTOR.17
VBAT: C79.1, C80.1, J6.1, VREG-MCU1.3 (VIN), VREG-MCU1.4 (VIN)

Notes on the sheet:
TRANSMISSION OF TOUCH VR
TOUCH GLOVE
Rev 3
Designed by: MrSwirlyEyes
ANALOG VOLTAGE AMPLIFIER
ET ARRAY - INDEX
ET ARRAY - MIDDLE
0x44
ET ARRAY - RING
0x45
ET ARRAY - PINKY
SQW GENERATOR
ELECTROTACTILE ARRAYS
STAGE1
STAGE2
STAGE3
+3.3V VREG
+1.8V VREG
-1.8V VREG
0x42
0x43

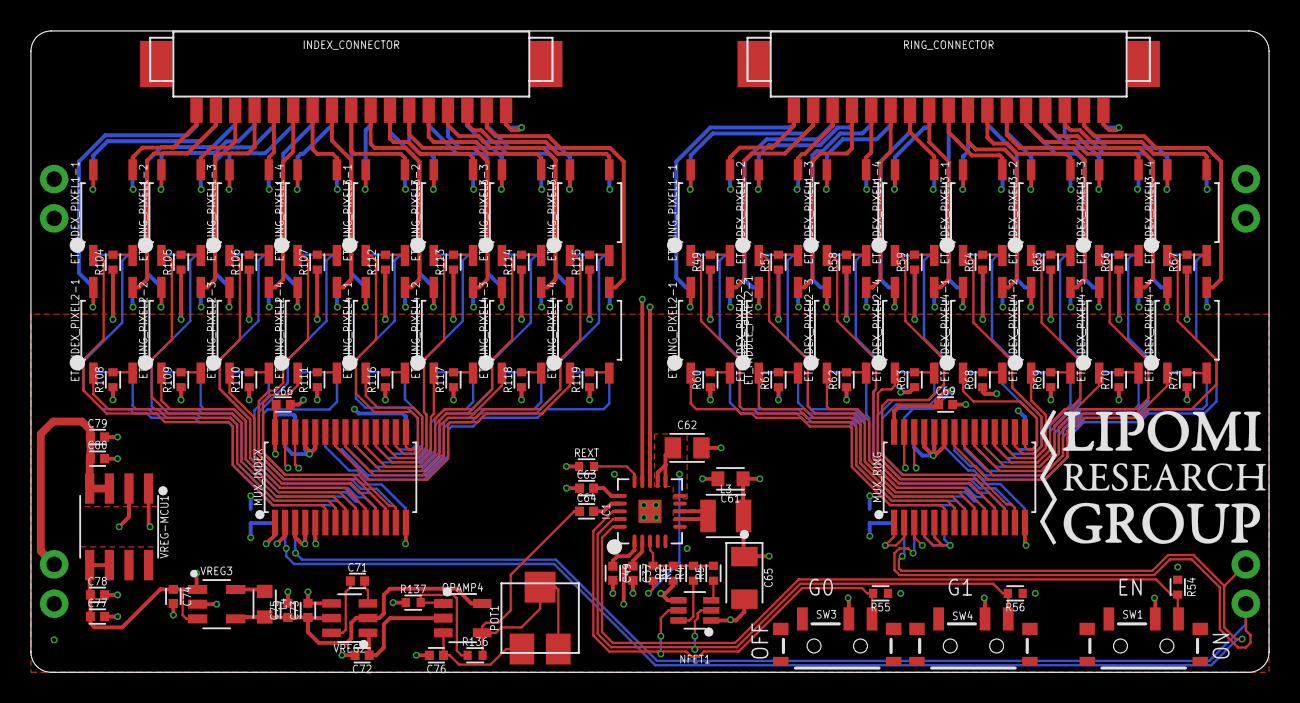
[picture p34: board electrotactile_extension.brd from above]

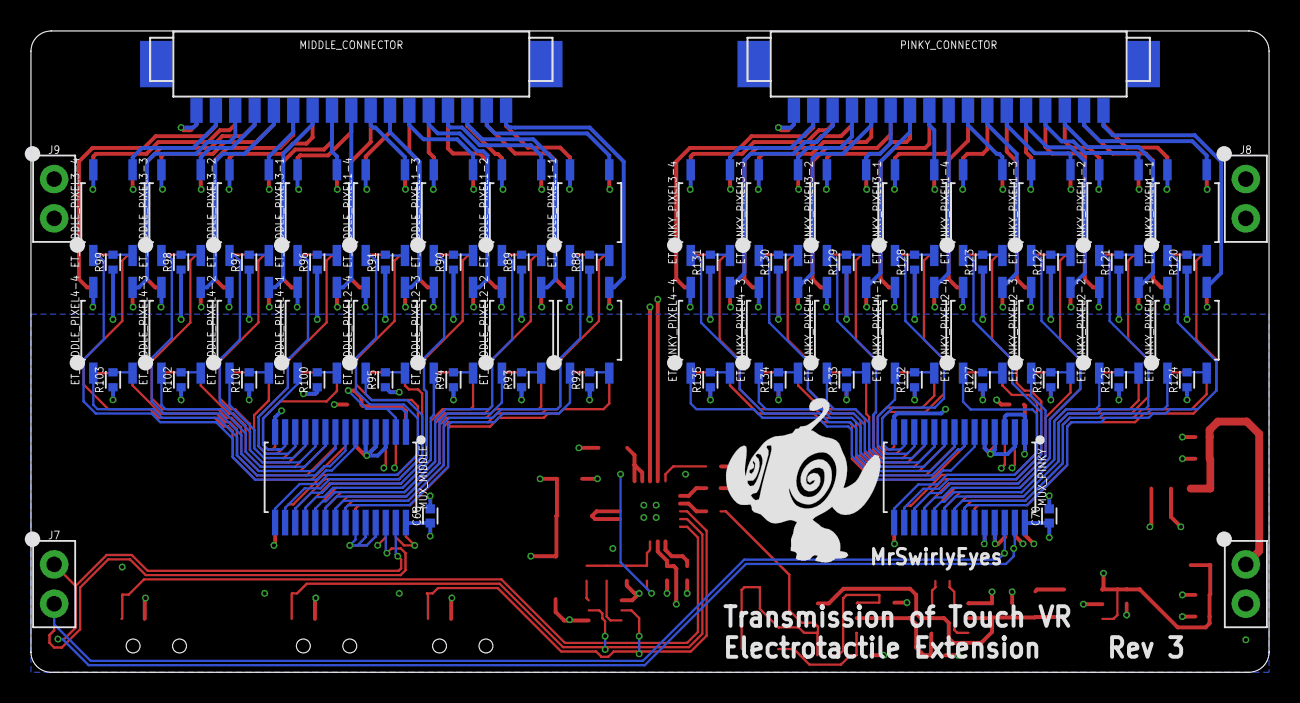
[picture p35: board electrotactile_extension.brd from below]

Board: 4 copper layers, 80.0 x 41.4 mm, 185 parts (75 on the bottom side), 219 nets.

Other parts of the board:
U$1: LRG-LOGO-2
U$2: MRSWIRLYEYES-LOGO
