MrSwirlyEyes/transmission_of_touch_vr/ecad/touch_glove/touch_glove.brd

## EAGLE design ecad/touch_glove/touch_glove.brd (2019-04-18)

Schematic: touch_glove.sch

Parts:
ANT: 2.45GHz; ANTC6522X100
AVR_ISP: AVR ISP; HDRV6W64P254_2X3_762X508X838B
BALUN1: 50/100; RESCAXE65P200X125X95-6
BL_CONNECTOR: PTH VERT MALE; HDRV2W64P254_1X2_508X254X838B
BR_ANALOG: NET_BRIDGE
BR_CONNECTOR: PTH VERT MALE; HDRV2W64P254_1X2_508X254X838B
BR_NOISE: NET_BRIDGE
C1, C2, C3, C18, C21: 100uF/10V; CAPCP3216X160
C4, C6, C8, C11, C12, C15: 10uF/6.3V; CAPC1005X55_SMD-0402
C5, C7, C9, C10, C13, C14, C22, C23, C25, C27, C30, C38, C44, C45, C46, C47, C48, C50, C51, C52, C53, C54, C55, C56, C57, C58, C59, C60: 0.1uF/50V; CAPC1005X55_SMD-0402
C24, C26, C28, C29, C31, C32: 1uF/25V; CAPC1005X55_SMD-0402
C33, C34: 12pF/100V; CAPC1005X55_SMD-0402
C35: 0.75pF/50V; CAPC1005X55_SMD-0402
C36: 22pF/100V/0402; CAPC1005X55_SMD-0402
D2, D3: 1A/50V; SODFL3516X170
D4, D5, D6, D7, D8, D9, D10: 150mA/75V; DFN100X60X55-2
DEMUX1: CH16_MUX-DEMUX; SOP65P780X200-24
FLEX-INDEX: 10K; _MOLEX-0530470210_VERT_PITCH-1.25MM
FLEX-MIDDLE: 10K; _MOLEX-0530470210_VERT_PITCH-1.25MM
FLEX-PINKY: 10K; _MOLEX-0530470210_VERT_PITCH-1.25MM
FLEX-RING: 10K; _MOLEX-0530470210_VERT_PITCH-1.25MM
FLEX-THUMB: 10K; _MOLEX-0530470210_VERT_PITCH-1.25MM
FTDI: PTH RA VERT MALE; HDRRA6W64P254_1X6_1524X254X254B_FTDI
HBRIDGE-INDEX: DRV8837C 1A; WSON-8-PPAD
HBRIDGE-MIDDLE: DRV8837C 1A; WSON-8-PPAD
HBRIDGE-PINKY: DRV8837C 1A; WSON-8-PPAD
HBRIDGE-RING: DRV8837C 1A; WSON-8-PPAD
HBRIDGE-THUMB: DRV8837C 1A; WSON-8-PPAD
J9: PTH VERT MALE; HDRV2W64P254_1X2_508X254X838B
JP1: JUMPER_SMD_3-PAD_NO_SILK; SMT-JUMPER_3_NO_SILK
L1, L2: 10uH/380mA; INDC1608X60-0603
LED1: BLUE; LEDC1005X40_LED-0402
LED2: GREEN; LEDC1005X40_LED-0402
LED3: RED; LEDC1005X40_LED-0402
LIPO1: 7.4V; BATTERY_MOLEX-0530470210_VERT_PITCH-1.25MM
MCU: ATMEGA128RFA1; QFN50P900X900X90-64
OPAMP1, OPAMP2, OPAMP3: LM358; WSON-8-PPAD
PWM_DRIVER1: PCA9685; SOP65P650X110-28
Q1, Q2, Q3, Q4, Q5, Q6: MCH3474 4A/30V; SOTFL65P209X90-3
R1, R11, R12, R13, R14, R15, R32, R33, R34, R35, R36, R37, R38, R39, R40, R41, R42, R43, R44, R45, R46, R47, R48: 10K; RESC1005X35_SMD-0402
R2, R3: 4.7K; RESC1005X35_SMD-0402
R4, R5: 1K; RESC1005X35_SMD-0402
SW1: 4A/28V; SW_SLIDE_SPDT_RA_PTH_12.7L-9.5W
TEC-INDEX: PELTIER; _MOLEX-0530470210_VERT_PITCH-1.25MM
TEC-MIDDLE: PELTIER; _MOLEX-0530470210_VERT_PITCH-1.25MM
TEC-PINKY: PELTIER; _MOLEX-0530470210_VERT_PITCH-1.25MM
TEC-RING: PELTIER; _MOLEX-0530470210_VERT_PITCH-1.25MM
TEC-THUMB: PELTIER; _MOLEX-0530470210_VERT_PITCH-1.25MM
TL_CONNECTOR: PTH VERT MALE; HDRV2W64P254_1X2_508X254X838B
VIBE-INDEX: Molex VERT 1.25mm pitch; _MOLEX-0530470210_VERT_PITCH-1.25MM
VIBE-MIDDLE: Molex VERT 1.25mm pitch; _MOLEX-0530470210_VERT_PITCH-1.25MM
VIBE-PALM: Molex VERT 1.25mm pitch; _MOLEX-0530470210_VERT_PITCH-1.25MM
VIBE-PINKY: Molex VERT 1.25mm pitch; _MOLEX-0530470210_VERT_PITCH-1.25MM
VIBE-RING: Molex VERT 1.25mm pitch; _MOLEX-0530470210_VERT_PITCH-1.25MM
VIBE-THUMB: Molex VERT 1.25mm pitch; _MOLEX-0530470210_VERT_PITCH-1.25MM
VREG-ANALOG: MCP1700-1802 1.8V/200mA; SOT95P237X112-3_SOT-23-3
VREG-MCU: TPS76833QDR 1A/3.3V; SOIC127P600X265-8
VREG-TEC: 3A/1.8V; TO170P1363X457-6
VREG-VIBE: TL1963A-33 1.5A/3.3V; SOT229P700X180-4
XTAL: 16 MHz; OSCCC500X320X110_CRYSTAL

Connections:
1.8V: C21.A, C56.1, C57.1, C58.1, C59.1, C60.1, D3.A, HBRIDGE-INDEX.1 (VM), HBRIDGE-MIDDLE.1 (VM), HBRIDGE-PINKY.1 (VM), HBRIDGE-RING.1 (VM), HBRIDGE-THUMB.1 (VM), VREG-TEC.4 (VOUT), VREG-TEC.5 (SENSE)
3.3V: C18.A, D2.A, D5.K, D6.K, D7.K, D8.K, D9.K, D10.K, VIBE-INDEX.1 (+), VIBE-MIDDLE.1 (+), VIBE-PALM.1 (+), VIBE-PINKY.1 (+), VIBE-RING.1 (+), VIBE-THUMB.1 (+), VREG-VIBE.3 (VO)
+: LIPO1.+, SW1.P
A1.8V: C14.1, C15.1, JP1.1, MCU.62 (AREF), VREG-ANALOG.2 (VO)
A3.3V: C29.1, C30.1, JP1.3, L2.2, MCU.59 (EVDD)
AGND: BALUN1.5 (GND), C14.2, C15.2, C29.2, C30.2, C31.2, C35.2, C36.2, C38.2, C44.2, C45.2, C46.2, C47.2, C48.2, DEMUX1.7 (C2), DEMUX1.8 (C1), DEMUX1.9 (C0), DEMUX1.12 (GND), DEMUX1.15 (!EN), DEMUX1.16 (C15), DEMUX1.17 (C14), DEMUX1.18 (C13), DEMUX1.19 (C12), DEMUX1.20 (C11), DEMUX1.21 (C10), DEMUX1.22 (C9), DEMUX1.23 (C8), L1.2, MCU.7 (AVSS_RFP), MCU.10 (AVSS_RFN), MCU.58 (AVSS), MCU.61 (AVSS), MCU.EP (AVSS), MCU.P$1 (AVSS), MCU.P$2 (AVSS), MCU.P$3 (AVSS), MCU.P$4 (AVSS), MCU.P$5 (AVSS), OPAMP1.4 (V-), OPAMP1.GND (V-), OPAMP1.P$1 (V-), OPAMP1.P$2 (V-), OPAMP2.4 (V-), OPAMP2.GND (V-), OPAMP2.P$1 (V-), OPAMP2.P$2 (V-), OPAMP3.4 (V-), OPAMP3.GND (V-), OPAMP3.P$1 (V-), OPAMP3.P$2 (V-), R11.1, R12.1, R13.1, R14.1, R15.1
FLEX-INDEX: DEMUX1.3 (C6), OPAMP1.1 (OUT-A), OPAMP1.2 (IN-A-)
FLEX-MIDDLE: DEMUX1.4 (C5), OPAMP2.6 (IN-B-), OPAMP2.7 (OUT-B)
FLEX-PINKY: DEMUX1.6 (C3), OPAMP3.1 (OUT-A), OPAMP3.2 (IN-A-)
FLEX-RING: DEMUX1.5 (C4), OPAMP2.1 (OUT-A), OPAMP2.2 (IN-A-)
FLEX-THUMB: DEMUX1.2 (C7), OPAMP1.6 (IN-B-), OPAMP1.7 (OUT-B)
GND: AVR_ISP.GND, BL_CONNECTOR.2, BR_ANALOG.P$1, BR_NOISE.P$2, C10.2, C11.2, C12.2, C13.2, C23.2, C24.2, C25.2, C26.2, C27.2, C28.2, C32.2, C33.2, C34.2, C50.2, C51.2, C52.2, C53.2, C54.2, C55.2, FTDI.GND, LIPO1.-, MCU.11 (TST), MCU.20 (DVSS), MCU.24 (DVSS), MCU.33 (CLKI), MCU.35 (DVSS), MCU.45 (DVSS), MCU.55 (DVSS), PWM_DRIVER1.1 (A0), PWM_DRIVER1.2 (A1), PWM_DRIVER1.3 (A2), PWM_DRIVER1.4 (A3), PWM_DRIVER1.5 (A4), PWM_DRIVER1.14 (GND), PWM_DRIVER1.23 (!OE), PWM_DRIVER1.24 (A5), PWM_DRIVER1.25 (EXTCLK), R4.1, R5.1, R32.1, R33.1, R34.1, R35.1, R36.1, R37.1, R38.1, R39.1, R40.1, R41.1, R42.1, R43.1, R44.1, R45.1, R46.1, R47.1, VREG-ANALOG.1 (GND), VREG-MCU.1 (GND), VREG-MCU.2 (!EN)
LED_RX: LED3.A, MCU.42 ((PCINT6/OC1B/D34-PWM34)PB6)
LED_TX: LED2.A, MCU.43 ((PCINT7/OC0A/OC1C/D35-PWM35)PB7)
MISO: AVR_ISP.MISO, MCU.39 ((PDO/PCINT3/MISO/D12)PB3)
MOSI: AVR_ISP.MOSI, MCU.38 ((PDI/PCINT2/MOSI/D11)PB2)
unnamed: HBRIDGE-THUMB.3 (OUT2), TEC-THUMB.1 (HOT)
unnamed: D8.A, Q4.3 (D), VIBE-INDEX.2 (-)
unnamed: D9.A, Q5.3 (D), VIBE-THUMB.2 (-)
unnamed: D7.A, Q3.3 (D), VIBE-MIDDLE.2 (-)
unnamed: HBRIDGE-THUMB.2 (OUT1), TEC-THUMB.2 (COLD)
unnamed: HBRIDGE-INDEX.2 (OUT1), TEC-INDEX.2 (COLD)
unnamed: HBRIDGE-INDEX.3 (OUT2), TEC-INDEX.1 (HOT)
unnamed: HBRIDGE-MIDDLE.3 (OUT2), TEC-MIDDLE.1 (HOT)
unnamed: D6.A, Q2.3 (D), VIBE-RING.2 (-)
unnamed: HBRIDGE-MIDDLE.2 (OUT1), TEC-MIDDLE.2 (COLD)
unnamed: D5.A, Q1.3 (D), VIBE-PINKY.2 (-)
unnamed: HBRIDGE-RING.3 (OUT2), TEC-RING.1 (HOT)
unnamed: HBRIDGE-RING.2 (OUT1), TEC-RING.2 (COLD)
unnamed: HBRIDGE-PINKY.3 (OUT2), TEC-PINKY.1 (HOT)
unnamed: HBRIDGE-PINKY.2 (OUT1), TEC-PINKY.2 (COLD)
unnamed: D10.A, Q6.3 (D), VIBE-PALM.2 (-)
unnamed: C34.1, MCU.56 (XTAL2), XTAL.3 (XTAL2)
unnamed: C33.1, MCU.57 (XTAL1), XTAL.1 (XTAL1)
unnamed: FLEX-INDEX.2 (-), OPAMP1.3 (IN-A+), R12.2
unnamed: BR_ANALOG.P$2, L1.1
unnamed: FLEX-RING.2 (-), OPAMP2.3 (IN-A+), R14.2
unnamed: BALUN1.3 (OUT1), MCU.9 (RFN)
unnamed: BALUN1.4 (OUT2), MCU.8 (RFP)
unnamed: BALUN1.2 (GND), C36.1
unnamed: C22.1, FTDI.DTR
unnamed: LED1.K, R48.2
unnamed: LED2.K, R4.2
unnamed: LED3.K, R5.2
unnamed: C32.1, MCU.21 (DVDD), MCU.22 (DVDD)
unnamed: C31.1, MCU.60 (AVDD)
unnamed: FLEX-MIDDLE.2 (-), OPAMP2.5 (IN-B+), R13.2
unnamed: FLEX-THUMB.2 (-), OPAMP1.5 (IN-B+), R11.2
unnamed: FLEX-PINKY.2 (-), OPAMP3.3 (IN-A+), R15.2
NGND: BR_NOISE.P$1, C1.K, C2.K, C3.K, C4.2, C5.2, C6.2, C7.2, C8.2, C9.2, C18.K, C21.K, C56.2, C57.2, C58.2, C59.2, C60.2, HBRIDGE-INDEX.4 (GND), HBRIDGE-INDEX.GND, HBRIDGE-INDEX.P$1 (GND), HBRIDGE-INDEX.P$2 (GND), HBRIDGE-MIDDLE.4 (GND), HBRIDGE-MIDDLE.GND, HBRIDGE-MIDDLE.P$1 (GND), HBRIDGE-MIDDLE.P$2 (GND), HBRIDGE-PINKY.4 (GND), HBRIDGE-PINKY.GND, HBRIDGE-PINKY.P$1 (GND), HBRIDGE-PINKY.P$2 (GND), HBRIDGE-RING.4 (GND), HBRIDGE-RING.GND, HBRIDGE-RING.P$1 (GND), HBRIDGE-RING.P$2 (GND), HBRIDGE-THUMB.4 (GND), HBRIDGE-THUMB.GND, HBRIDGE-THUMB.P$1 (GND), HBRIDGE-THUMB.P$2 (GND), Q1.2 (S), Q2.2 (S), Q3.2 (S), Q4.2 (S), Q5.2 (S), Q6.2 (S), R48.1, TL_CONNECTOR.1, TL_CONNECTOR.2, VREG-TEC.3 (GND), VREG-TEC.TAB (GND), VREG-VIBE.2 (GND), VREG-VIBE.TAB (GND)
RESET: AVR_ISP.RESET, C22.2, D4.A, MCU.12 (RSTN), R1.1
RFSIG: ANT.1, BALUN1.1 (IN), C35.1
RX0: FTDI.TXO, MCU.46 ((PCINT8/RXD0/D0)PE0)
S0: DEMUX1.10 (S0), MCU.29 ((ICP1/D22)PD4)
S1: DEMUX1.11 (S1), MCU.30 ((XCK1/D23)PD5)
S2: DEMUX1.14 (S2), MCU.32 ((T0/D25)PD7)
S3: DEMUX1.13 (S3), MCU.31 ((T1/D24)PD6)
SCK: AVR_ISP.SCK, MCU.37 ((PCINT1/SCK/D13)PB1)
SCL: BR_CONNECTOR.2, MCU.25 ((INT0/SCL/D15)PD0), PWM_DRIVER1.26 (SCL), R2.1
SDA: BR_CONNECTOR.1, MCU.26 ((INT1/SDA/D14)PD1), PWM_DRIVER1.27 (SDA), R3.1
SIG: DEMUX1.1 (SIG), MCU.63 ((ADC0/A0*)PF0)
TEC-INDEX-COLD: HBRIDGE-INDEX.5 (IN2/EN), PWM_DRIVER1.17 (PWM10), R41.2
TEC-INDEX-HOT: HBRIDGE-INDEX.6 (IN1/PH), PWM_DRIVER1.18 (PWM11), R40.2
TEC-MIDDLE-COLD: HBRIDGE-MIDDLE.5 (IN2/EN), PWM_DRIVER1.19 (PWM12), R43.2
TEC-MIDDLE-HOT: HBRIDGE-MIDDLE.6 (IN1/PH), PWM_DRIVER1.20 (PWM13), R42.2
TEC-PINKY-COLD: HBRIDGE-PINKY.5 (IN2/EN), PWM_DRIVER1.13 (PWM7), R47.2
TEC-PINKY-HOT: HBRIDGE-PINKY.6 (IN1/PH), PWM_DRIVER1.12 (PWM6), R46.2
TEC-RING-COLD: HBRIDGE-RING.5 (IN2/EN), PWM_DRIVER1.21 (PWM14), R45.2
TEC-RING-HOT: HBRIDGE-RING.6 (IN1/PH), PWM_DRIVER1.22 (PWM15), R44.2
TEC-THUMB-COLD: HBRIDGE-THUMB.5 (IN2/EN), PWM_DRIVER1.15 (PWM8), R39.2
TEC-THUMB-HOT: HBRIDGE-THUMB.6 (IN1/PH), PWM_DRIVER1.16 (PWM9), R38.2
TX0: FTDI.RXI, MCU.47 ((TXD0/D1)PE1)
VBAT: BL_CONNECTOR.1, C1.A, C2.A, C3.A, C4.1, C5.1, C6.1, C7.1, C8.1, C9.1, D2.K, D3.K, LED1.A, SW1.S1, VREG-MCU.3 (VIN), VREG-MCU.4 (VIN), VREG-TEC.1 (!SHDN), VREG-TEC.2 (VIN), VREG-VIBE.1 (VI)
VCC: C10.1, C11.1, C12.1, C13.1, C23.1, C24.1, C25.1, C26.1, C27.1, C28.1, C50.1, C51.1, C52.1, C53.1, C54.1, C55.1, D4.K, HBRIDGE-INDEX.7 (NSLEEP), HBRIDGE-INDEX.8 (VCC), HBRIDGE-MIDDLE.7 (NSLEEP), HBRIDGE-MIDDLE.8 (VCC), HBRIDGE-PINKY.7 (NSLEEP), HBRIDGE-PINKY.8 (VCC), HBRIDGE-RING.7 (NSLEEP), HBRIDGE-RING.8 (VCC), HBRIDGE-THUMB.7 (NSLEEP), HBRIDGE-THUMB.8 (VCC), L2.1, MCU.23 (DEVDD), MCU.34 (DEVDD), MCU.44 (DEVDD), MCU.54 (DEVDD), PWM_DRIVER1.28 (VCC), R1.2, R2.2, R3.2, VREG-ANALOG.3 (VI), VREG-MCU.5 (VOUT), VREG-MCU.6 (VOUT)
VIBE-INDEX: PWM_DRIVER1.9 (PWM3), Q4.1 (G), R35.2
VIBE-MIDDLE: PWM_DRIVER1.8 (PWM2), Q3.1 (G), R34.2
VIBE-PALM: PWM_DRIVER1.11 (PWM5), Q6.1 (G), R37.2
VIBE-PINKY: PWM_DRIVER1.6 (PWM0), Q1.1 (G), R32.2
VIBE-RING: PWM_DRIVER1.7 (PWM1), Q2.1 (G), R33.2
VIBE-THUMB: PWM_DRIVER1.10 (PWM4), Q5.1 (G), R36.2
VSENSOR: C38.1, C44.1, C45.1, C46.1, C47.1, C48.1, DEMUX1.24 (VCC), FLEX-INDEX.1 (+), FLEX-MIDDLE.1 (+), FLEX-PINKY.1 (+), FLEX-RING.1 (+), FLEX-THUMB.1 (+), JP1.2, OPAMP1.8 (V+), OPAMP2.8 (V+), OPAMP3.8 (V+)

Notes on the sheet:
VIBROTACTILES
PELTIER DRIVERS
FLEX SENSORS
ANALOG DEMUX
PWM DRIVER
ATMEGA128RFA1
ACTUATORS
SENSORS
AVR ISP
FTDI
PROGRAMMER
POWER SYSTEM
MCU
LPF
TRANSMISSION OF TOUCH VR
TOUCH GLOVE
Rev 3
THERMOELECTRICS
Designed by: MrSwirlyEyes
LEDS

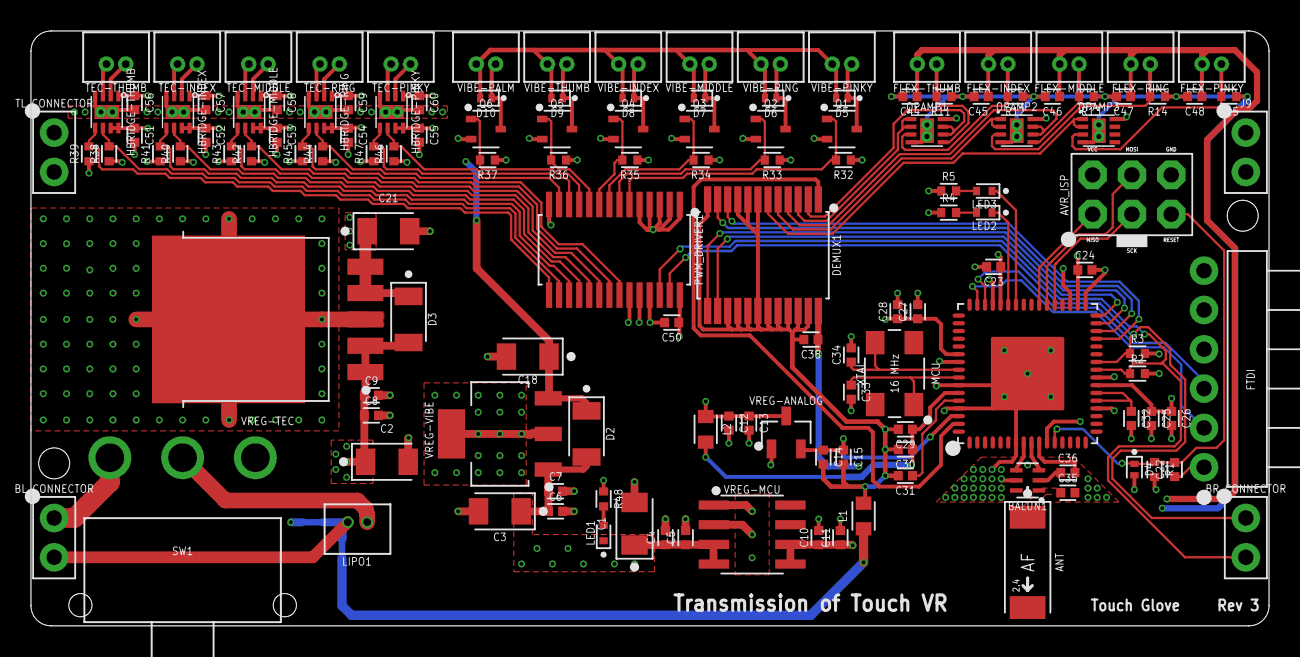
[picture p36: board touch_glove.brd from above]

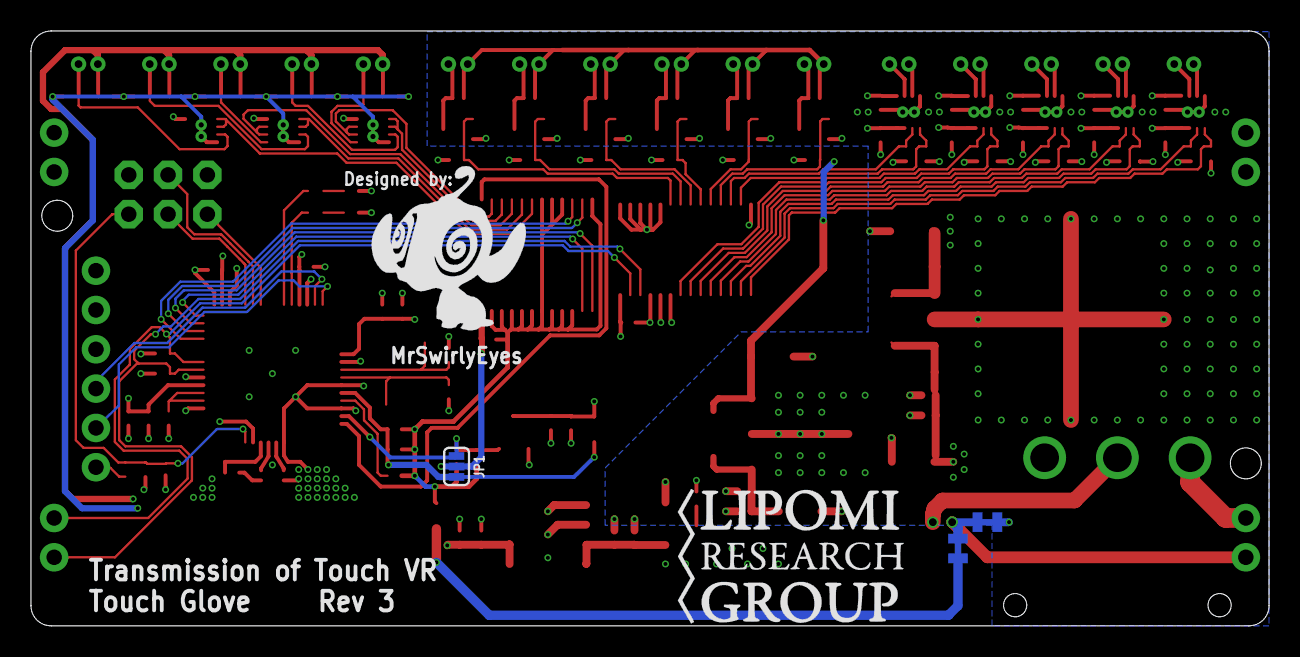
[picture p37: board touch_glove.brd from below]

Board: 4 copper layers, 80.0 x 38.4 mm, 143 parts (5 on the bottom side), 81 nets.

Other parts of the board:
U$1: LRG-LOGO-2
U$2: MRSWIRLYEYES-LOGO
