MrSwirlyEyes/transmission_of_touch_vr/ecad/robotic_arm/robotic_arm.brd

## EAGLE design ecad/robotic_arm/robotic_arm.brd (2019-04-18)

Schematic: robotic_arm.sch

Parts:
A6: 2.45GHz; ANTC6522X100
AVR_ISP: AVR ISP; HDRV6W64P254_2X3_762X508X838B
B1: 50/100; RESCAXE65P200X125X95-6
C1, C2, C3, C4, C5, C6, C7, C10, C12, C14, C16, C19, C22, C24, C26, C28, C30, C47, C48, C49, C50, C51, C52, C53, C54, C63, C79, C83, C85, C93, C96, C98: 0.1uF/50V; CAPC1005X55_SMD-0402
C8, C29, C92: 10uF/6.3V; CAPC1005X55_SMD-0402
C9, C11, C13, C15, C17: 100uF/25V; CAPPRD200W50D500H1100B
C20, C27, C80: 1000uF/16V; CAPPRD350W60D800H2000B
C21, C23, C55, C57, C58: 1uF/25V; CAPC1005X55_SMD-0402
C59, C60: 12pF/100V; CAPC1005X55_SMD-0402
C61: 22pF/100V/0402; CAPC1005X55_SMD-0402
C62: 0.75pF/50V; CAPC1005X55_SMD-0402
C94, C95, C97: 10uF/25V; CAPC2012X95_SMD-0805
D1: 150mA/75V; DFN100X60X55-2
D2, D7: 1A/50V; SODFL3516X170
DEMUX1: CH16_MUX-DEMUX; SOP65P780X200-24
FSR_INDEX: 10K; _MOLEX-0530470210_VERT_PITCH-1.25MM
FSR_MIDDLE: 10K; _MOLEX-0530470210_VERT_PITCH-1.25MM
FSR_PALM: 10K; _MOLEX-0530470210_VERT_PITCH-1.25MM
FSR_PINKY: 10K; _MOLEX-0530470210_VERT_PITCH-1.25MM
FSR_RING: 10K; _MOLEX-0530470210_VERT_PITCH-1.25MM
FSR_THUMB: 10K; _MOLEX-0530470210_VERT_PITCH-1.25MM
J1: 5A/28V; POWER_JACK_PTH_ID2.1MM-OD5.5MM
JP1: PTH RA VERT MALE; HDRRA6W64P254_1X6_1524X254X254B_FTDI
JP3: JUMPER_SMD_3-PAD_NO_SILK; SMT-JUMPER_3_NO_SILK
L1, L2: 10uH/380mA; INDC1608X60-0603
LED1: BLUE; LEDC1005X40_LED-0402
LIPO1: LIPO 2S; 1X02_WIRE_CONNECTOR_AWG-18
MCU: ATMEGA128RFA1; QFN50P900X900X90-64
NOISE_BR, NOISE_BR1: NET_BRIDGE
PWM_DRIVER: PCA9685; SOP65P650X110-28
R1, R10, R16, R39, R40, R41, R42, R43: 10K; RESC1005X35_SMD-0402
R2, R3: 1K; RESC1005X35_SMD-0402
R17, R18: 4.7K; RESC1005X35_SMD-0402
RX_LED: RED; LEDC1005X40_LED-0402
SERVO_INDEX: HK15298B; HDRV3W64P254_1X3_762X254X838B
SERVO_MIDDLE: HK15298B; HDRV3W64P254_1X3_762X254X838B
SERVO_PINKY: HK15298B; HDRV3W64P254_1X3_762X254X838B
SERVO_RING: HK15298B; HDRV3W64P254_1X3_762X254X838B
SERVO_THUMB: HK15298B; HDRV3W64P254_1X3_762X254X838B
SW1: 5A/28V; SW_TOGGLE_SPDT_5A-28V_13L-7W
TEMP_INDEX: TMP36; _MOLEX-0530470310_VERT_PITCH-1.25MM
TEMP_MIDDLE: TMP36; _MOLEX-0530470310_VERT_PITCH-1.25MM
TEMP_PINKY: TMP36; _MOLEX-0530470310_VERT_PITCH-1.25MM
TEMP_RING: TMP36; _MOLEX-0530470310_VERT_PITCH-1.25MM
TEMP_THUMB: TMP36; _MOLEX-0530470310_VERT_PITCH-1.25MM
TX_LED: GREEN; LEDC1005X40_LED-0402
VREG-ANALOG: MCP1700-1802 1.8V/200mA; SOT95P237X112-3_SOT-23-3
VREG-MCU: TPS76833QDR 1A/3.3V; SOIC127P600X265-8
VREG-SERVOS: MIC29501-5.0 5A/5V; TO170P1363X457-6
Y1: 16 MHz; OSCCC500X320X110_CRYSTAL

Connections:
3.3V: C19.1, C24.1, C52.1, C53.1, C54.1, C55.1, C58.1, C63.1, C92.1, C93.1, D1.K, D2.A, L1.1, MCU.23 (DEVDD), MCU.34 (DEVDD), MCU.44 (DEVDD), MCU.54 (DEVDD), PWM_DRIVER.28 (VCC), R17.2, R18.2, R43.2, VREG-MCU.5 (VOUT), VREG-MCU.6 (VOUT)
5V: C1.1, C9.A, C10.1, C11.A, C12.1, C13.A, C14.1, C15.A, C16.1, C17.A, C20.A, C83.1, C94.1, D7.A, SERVO_INDEX.VCC, SERVO_MIDDLE.VCC, SERVO_PINKY.VCC, SERVO_RING.VCC, SERVO_THUMB.VCC, VREG-SERVOS.4 (VOUT)
+: J1.PWR, LIPO1.+, SW1.S1
-: J1.GND_BATTERY, LIPO1.-
A1.8V: C28.1, C29.1, JP3.1, MCU.62 (AREF), VREG-ANALOG.2 (VO)
A3.3V: C2.1, C3.1, C4.1, C5.1, C6.1, C7.1, C8.1, C22.1, C23.1, C26.1, C85.1, DEMUX1.24 (VCC), JP3.3, L1.2, MCU.59 (EVDD), TEMP_INDEX.VCC, TEMP_MIDDLE.VCC, TEMP_PINKY.VCC, TEMP_RING.VCC, TEMP_THUMB.VCC, VREG-ANALOG.3 (VI)
AGND: B1.5 (GND), C2.2, C3.2, C4.2, C5.2, C6.2, C7.2, C8.2, C22.2, C23.2, C24.2, C26.2, C28.2, C29.2, C30.2, C47.2, C48.2, C49.2, C50.2, C51.2, C61.2, C62.2, C85.2, DEMUX1.2 (C7), DEMUX1.3 (C6), DEMUX1.12 (GND), DEMUX1.15 (!EN), DEMUX1.21 (C10), DEMUX1.22 (C9), DEMUX1.23 (C8), L2.2, MCU.7 (AVSS_RFP), MCU.10 (AVSS_RFN), MCU.58 (AVSS), MCU.61 (AVSS), MCU.EP (AVSS), MCU.P$1 (AVSS), MCU.P$2 (AVSS), MCU.P$3 (AVSS), MCU.P$4 (AVSS), MCU.P$5 (AVSS), R10.1, R16.1, R39.1, R40.1, R41.1, R42.1, TEMP_INDEX.GND, TEMP_MIDDLE.GND, TEMP_PINKY.GND, TEMP_RING.GND, TEMP_THUMB.GND, VREG-ANALOG.1 (GND)
FSR_INDEX: DEMUX1.8 (C1), FSR_INDEX.2 (-), R39.2
FSR_MIDDLE: DEMUX1.7 (C2), FSR_MIDDLE.2 (-), R40.2
FSR_PALM: DEMUX1.4 (C5), FSR_PALM.2 (-), R10.2
FSR_PINKY: DEMUX1.5 (C4), FSR_PINKY.2 (-), R42.2
FSR_RING: DEMUX1.6 (C3), FSR_RING.2 (-), R41.2
FSR_THUMB: DEMUX1.9 (C0), FSR_THUMB.2 (-), R16.2
GND: AVR_ISP.GND, C19.2, C21.2, C27.K, C52.2, C53.2, C54.2, C55.2, C57.2, C58.2, C59.1, C60.1, C63.2, C80.K, C92.2, C93.2, C95.2, C96.2, J1.GND_JACK, JP1.GND, MCU.11 (TST), MCU.20 (DVSS), MCU.24 (DVSS), MCU.33 (CLKI), MCU.35 (DVSS), MCU.45 (DVSS), MCU.55 (DVSS), NOISE_BR.P$2, NOISE_BR1.P$1, PWM_DRIVER.1 (A0), PWM_DRIVER.2 (A1), PWM_DRIVER.3 (A2), PWM_DRIVER.4 (A3), PWM_DRIVER.5 (A4), PWM_DRIVER.14 (GND), PWM_DRIVER.23 (!OE), PWM_DRIVER.24 (A5), PWM_DRIVER.25 (EXTCLK), R1.1, R2.1, R3.1, VREG-MCU.1 (GND), VREG-MCU.2 (!EN)
MISO: AVR_ISP.MISO, MCU.39 ((PDO/PCINT3/MISO/D12)PB3)
MOSI: AVR_ISP.MOSI, MCU.38 ((PDI/PCINT2/MOSI/D11)PB2)
unnamed: L2.1, NOISE_BR1.P$2
unnamed: LED1.K, R1.2
unnamed: R3.2, TX_LED.K
unnamed: R2.2, RX_LED.K
unnamed: C21.1, MCU.21 (DVDD), MCU.22 (DVDD)
unnamed: C57.1, MCU.60 (AVDD)
unnamed: C60.2, MCU.57 (XTAL1), Y1.1 (XTAL1)
unnamed: B1.3 (OUT1), MCU.9 (RFN)
unnamed: B1.4 (OUT2), MCU.8 (RFP)
unnamed: B1.2 (GND), C61.1
unnamed: C59.2, MCU.56 (XTAL2), Y1.3 (XTAL2)
unnamed: A6.1, B1.1 (IN), C62.1
unnamed: C79.1, JP1.DTR
NGND: C1.2, C9.K, C10.2, C11.K, C12.2, C13.K, C14.2, C15.K, C16.2, C17.K, C20.K, C83.2, C94.2, C97.2, C98.2, NOISE_BR.P$1, SERVO_INDEX.GND, SERVO_MIDDLE.GND, SERVO_PINKY.GND, SERVO_RING.GND, SERVO_THUMB.GND, VREG-SERVOS.3 (GND), VREG-SERVOS.TAB (GND)
RESET: AVR_ISP.RESET, C79.2, D1.A, MCU.12 (RSTN), R43.1
RX: JP1.TXO, MCU.46 ((PCINT8/RXD0/D0)PE0)
RX_LED: MCU.42 ((PCINT6/OC1B/D34-PWM34)PB6), RX_LED.A
S0: DEMUX1.10 (S0), MCU.50 ((INT4/OC3B/D4-PWM4)PE4)
S1: DEMUX1.11 (S1), MCU.49 ((AIN1/OC3A/D3-PWM3)PE3)
S2: DEMUX1.14 (S2), MCU.52 ((T3/INT6/D6)PE6)
S3: DEMUX1.13 (S3), MCU.51 ((INT5/OC3C/D5-PWM5)PE5)
SCK: AVR_ISP.SCK, MCU.37 ((PCINT1/SCK/D13)PB1)
SCL: MCU.25 ((INT0/SCL/D15)PD0), PWM_DRIVER.26 (SCL), R17.1
SDA: MCU.26 ((INT1/SDA/D14)PD1), PWM_DRIVER.27 (SDA), R18.1
SERVO_INDEX: PWM_DRIVER.18 (PWM11), SERVO_INDEX.SIG
SERVO_MIDDLE: PWM_DRIVER.17 (PWM10), SERVO_MIDDLE.SIG
SERVO_PINKY: PWM_DRIVER.15 (PWM8), SERVO_PINKY.SIG
SERVO_RING: PWM_DRIVER.16 (PWM9), SERVO_RING.SIG
SERVO_THUMB: PWM_DRIVER.19 (PWM12), SERVO_THUMB.SIG
SIG: DEMUX1.1 (SIG), MCU.1 ((ADC2/DIG2/A2*)PF2)
TEMP_INDEX: DEMUX1.17 (C14), TEMP_INDEX.SIG
TEMP_MIDDLE: DEMUX1.18 (C13), TEMP_MIDDLE.SIG
TEMP_PINKY: DEMUX1.20 (C11), TEMP_PINKY.SIG
TEMP_RING: DEMUX1.19 (C12), TEMP_RING.SIG
TEMP_THUMB: DEMUX1.16 (C15), TEMP_THUMB.SIG
TX: JP1.RXI, MCU.47 ((TXD0/D1)PE1)
TX_LED: MCU.43 ((PCINT7/OC0A/OC1C/D35-PWM35)PB7), TX_LED.A
VBAT: C27.A, C80.A, C95.1, C96.1, C97.1, C98.1, D2.K, D7.K, LED1.A, SW1.P, VREG-MCU.3 (VIN), VREG-MCU.4 (VIN), VREG-SERVOS.1 (EN), VREG-SERVOS.2 (VIN)
VSENSOR: C30.1, C47.1, C48.1, C49.1, C50.1, C51.1, FSR_INDEX.1 (+), FSR_MIDDLE.1 (+), FSR_PALM.1 (+), FSR_PINKY.1 (+), FSR_RING.1 (+), FSR_THUMB.1 (+), JP3.2

Notes on the sheet:
TEMP SENSORS
NOTE: Value depends on sensitivity
SERVOS
ANALOG DEMUX
PWM DRIVER
FORCE SENSITIVE RESISTORS
Might add op amps
ATMEGA128RFA1
ACTUATORS
SENSORS
AVR ISP
FTDI
PROGRAMMER
POWER SYSTEM
MCU
LPF
TRANSMISSION OF TOUCH VR
ROBOTIC ARM
Rev 3

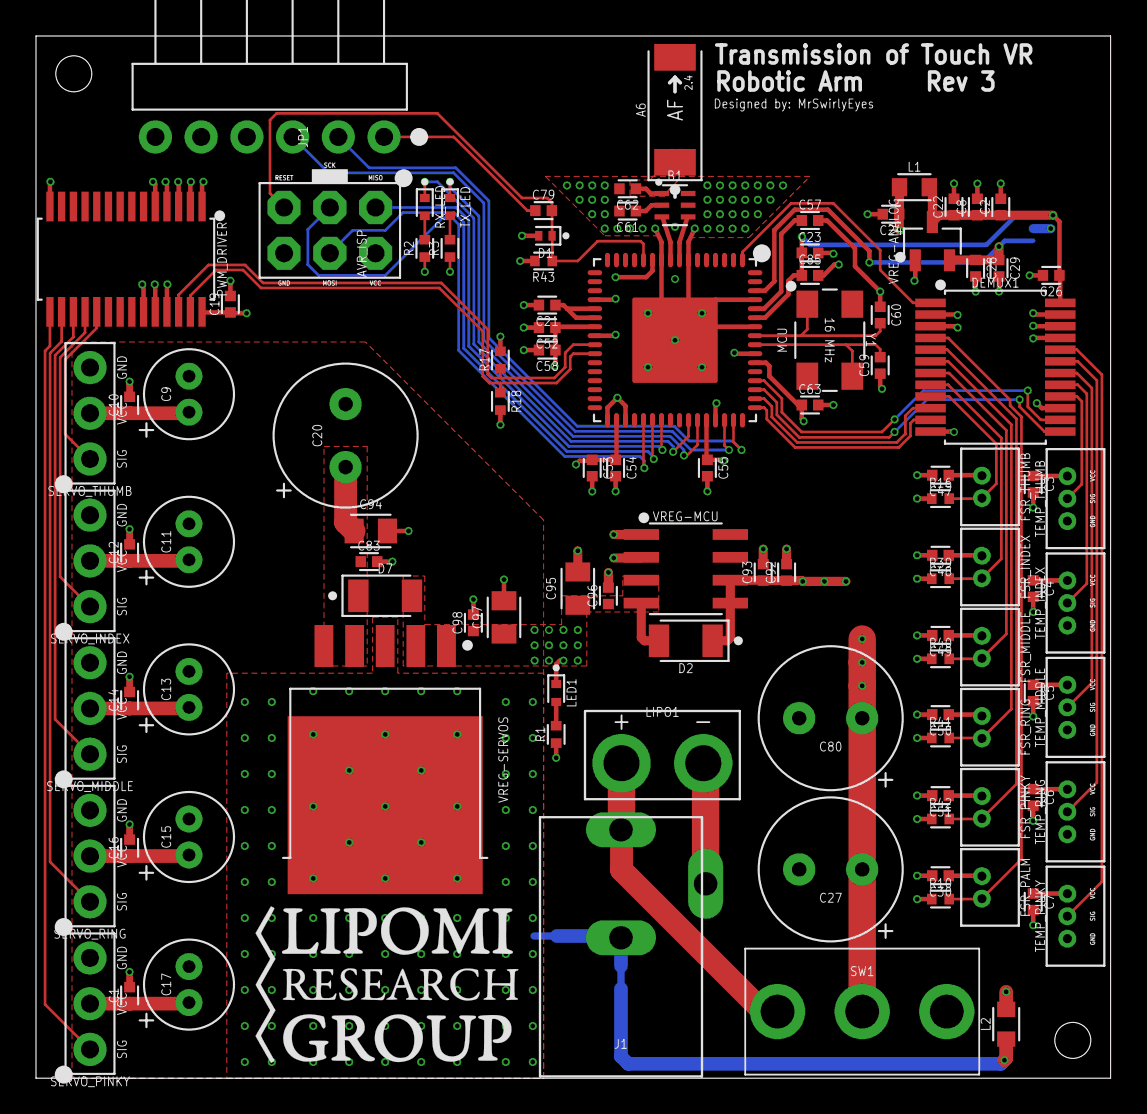
[picture p38: board robotic_arm.brd from above]

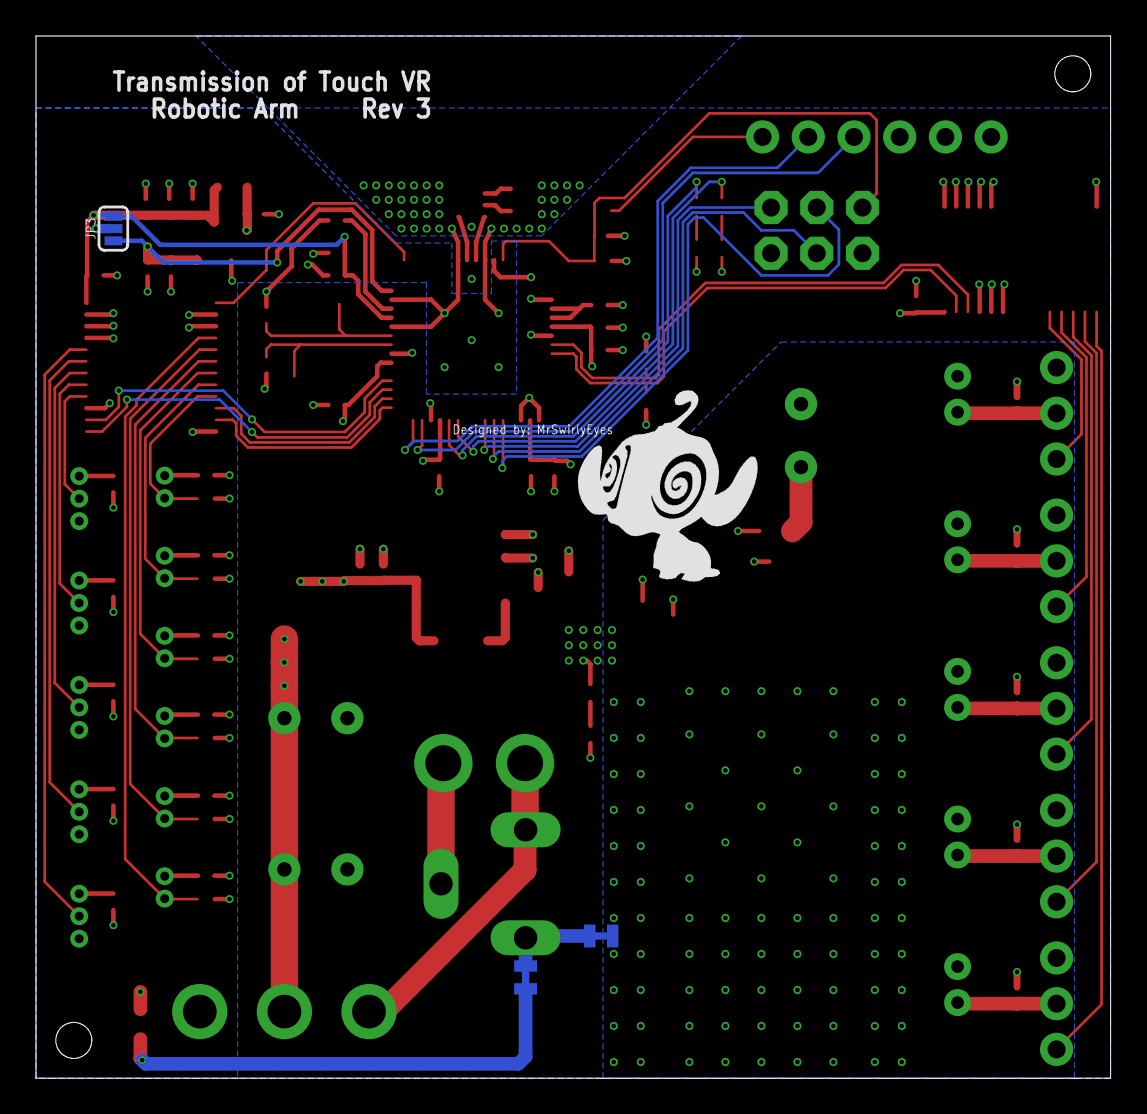
[picture p39: board robotic_arm.brd from below]

Board: 4 copper layers, 59.7 x 57.9 mm, 112 parts (4 on the bottom side), 55 nets.

Other parts of the board:
U$17, U$18: HOLE_2MM
U$20: MRSWIRLYEYES-LOGO
U$21: LRG-LOGO
