MrSwirlyEyes/transmission_of_touch_vr/doc/robotic_arm/schematic_force_sensitive_resistor_driver/schematic_force_sensitive_resistor_driver.sch

## EAGLE design doc/robotic_arm/schematic_force_sensitive_resistor_driver/schematic_force_sensitive_resistor_driver.sch (2019-02-06)

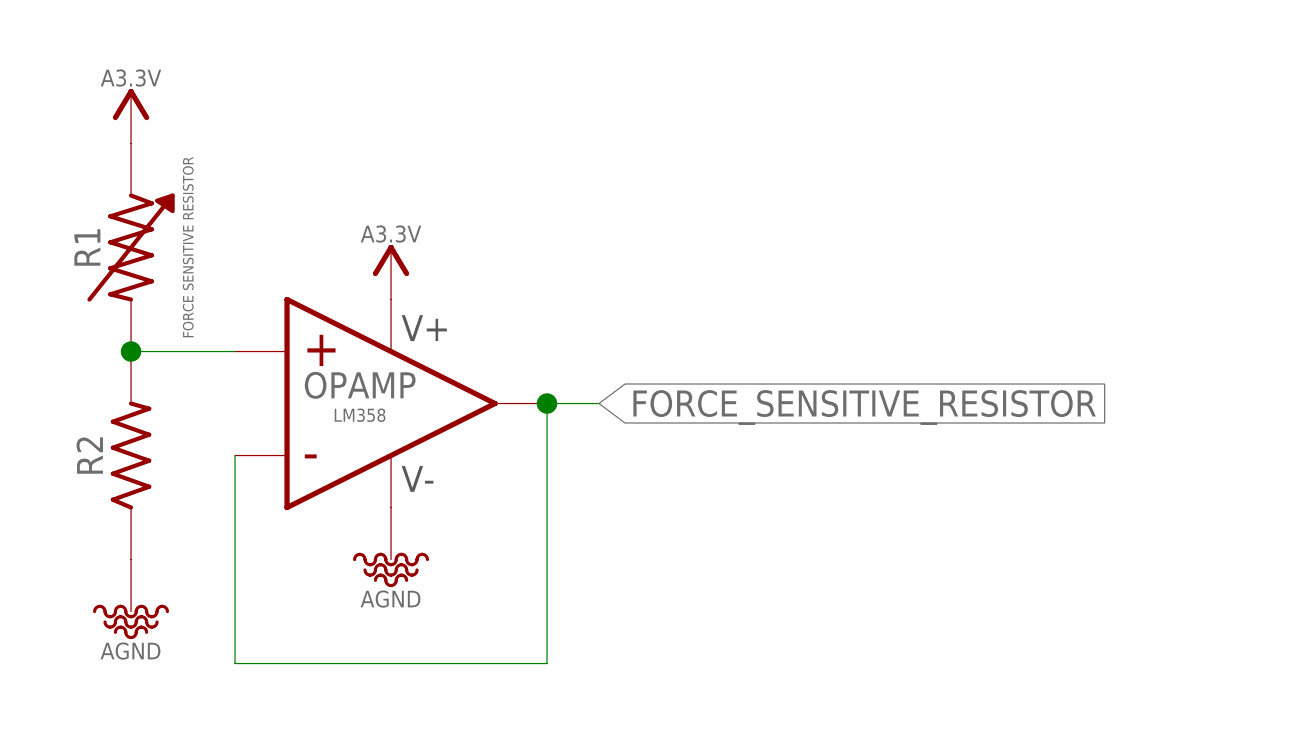
[picture p40: schematic schematic_force_sensitive_resistor_driver.sch]

Parts:
OPAMP: OPAMP_ILLUSTRATIVE; SOT95P280X145-5
R1: FORCE SENSITIVE RESISTOR; PTH-CONNECTOR-2PIN
R2: 10K; RESC1005X35_SMD-0402

Connections:
A3.3V: OPAMP.4 (V+), R1.1
AGND: OPAMP.5 (V-), R2.1
FORCE_SENSITIVE_RESISTOR: OPAMP.2 (IN-), OPAMP.3 (OUT)
unnamed: OPAMP.1 (IN+), R1.2, R2.2

Notes on the sheet:
LM358
