MrSwirlyEyes/transmission_of_touch_vr/doc/robotic_arm/schematic_servo_driver/schematic_servo_driver.sch

## EAGLE design doc/robotic_arm/schematic_servo_driver/schematic_servo_driver.sch (2019-03-03)

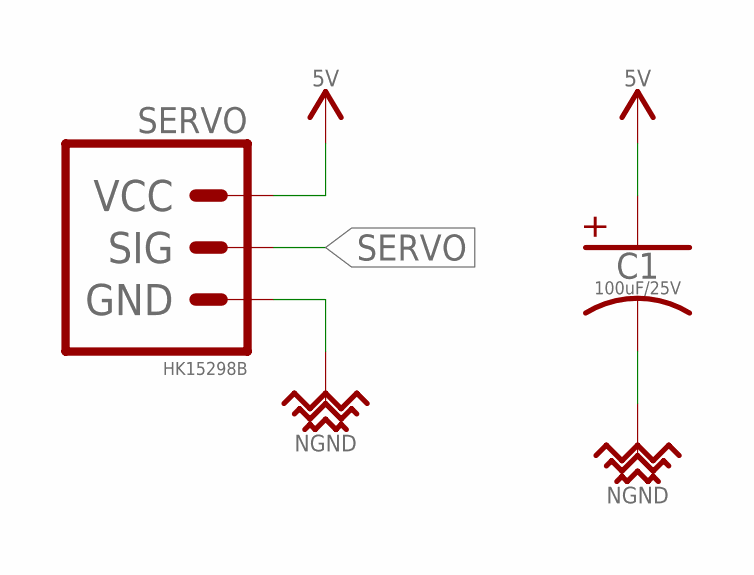
[picture p41: schematic schematic_servo_driver.sch]

Parts:
C1: 100uF/25V; _AE_PTH-DIA5-LS2-H11
SERVO: HK15298B; HDRV3W64P254_1X3_762X254X838B

Connections:
5V: C1.+ (A), SERVO.VCC
NGND: C1.- (K), SERVO.GND
SERVO: SERVO.SIG
