MrSwirlyEyes/transmission_of_touch_vr/doc/touch_glove/schematic_electrotactile_driver_stage3/stage3.sch

## EAGLE design doc/touch_glove/schematic_electrotactile_driver_stage3/stage3.sch (2019-09-28)

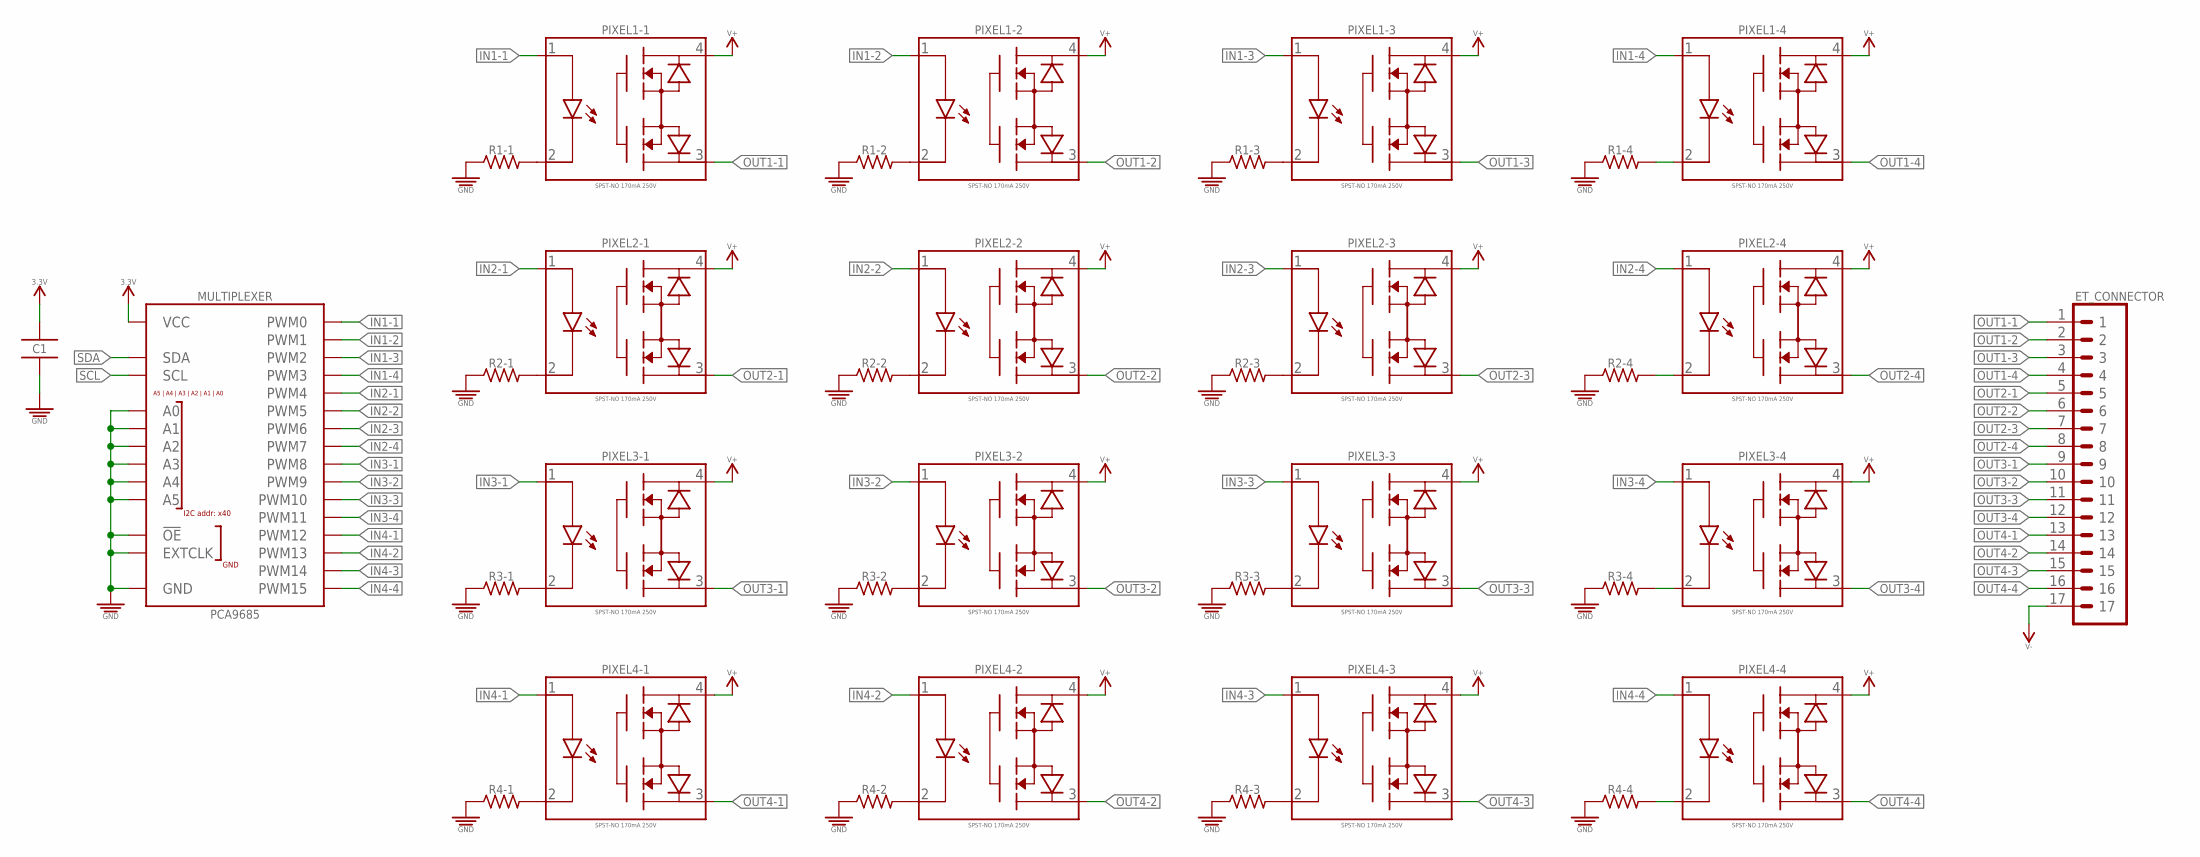
[picture p42: schematic stage3.sch]

Parts:
C1: 0.1uF/50V; CAPC1005X55_SMD-0402
ET_CONNECTOR: 1x17 MOLEX SMD RA; 1X17_MOLEX_0532611771_RA_SMD
MULTIPLEXER: PCA9685; SOP65P650X110-28
PIXEL1-1, PIXEL1-2, PIXEL1-3, PIXEL1-4, PIXEL2-1, PIXEL2-2, PIXEL2-3, PIXEL2-4, PIXEL3-1, PIXEL3-2, PIXEL3-3, PIXEL3-4, PIXEL4-1, PIXEL4-2, PIXEL4-3, PIXEL4-4: SPST-NO 170mA 250V; SOP254P609X203-4
R1-1, R1-2, R1-3, R1-4, R2-1, R2-2, R2-3, R2-4, R3-1, R3-2, R3-3, R3-4, R4-1, R4-2, R4-3, R4-4: 1K; RESC1005X35_SMD-0402

Connections:
3.3V: C1.1, MULTIPLEXER.28 (VCC)
GND: C1.2, MULTIPLEXER.1 (A0), MULTIPLEXER.2 (A1), MULTIPLEXER.3 (A2), MULTIPLEXER.4 (A3), MULTIPLEXER.5 (A4), MULTIPLEXER.14 (GND), MULTIPLEXER.23 (!OE), MULTIPLEXER.24 (A5), MULTIPLEXER.25 (EXTCLK), R1-1.1, R1-2.1, R1-3.1, R1-4.1, R2-1.1, R2-2.1, R2-3.1, R2-4.1, R3-1.1, R3-2.1, R3-3.1, R3-4.1, R4-1.1, R4-2.1, R4-3.1, R4-4.1
IN1-1: MULTIPLEXER.6 (PWM0), PIXEL1-1.1
IN1-2: MULTIPLEXER.7 (PWM1), PIXEL1-2.1
IN1-3: MULTIPLEXER.8 (PWM2), PIXEL1-3.1
IN1-4: MULTIPLEXER.9 (PWM3), PIXEL1-4.1
IN2-1: MULTIPLEXER.10 (PWM4), PIXEL2-1.1
IN2-2: MULTIPLEXER.11 (PWM5), PIXEL2-2.1
IN2-3: MULTIPLEXER.12 (PWM6), PIXEL2-3.1
IN2-4: MULTIPLEXER.13 (PWM7), PIXEL2-4.1
IN3-1: MULTIPLEXER.15 (PWM8), PIXEL3-1.1
IN3-2: MULTIPLEXER.16 (PWM9), PIXEL3-2.1
IN3-3: MULTIPLEXER.17 (PWM10), PIXEL3-3.1
IN3-4: MULTIPLEXER.18 (PWM11), PIXEL3-4.1
IN4-1: MULTIPLEXER.19 (PWM12), PIXEL4-1.1
IN4-2: MULTIPLEXER.20 (PWM13), PIXEL4-2.1
IN4-3: MULTIPLEXER.21 (PWM14), PIXEL4-3.1
IN4-4: MULTIPLEXER.22 (PWM15), PIXEL4-4.1
unnamed: PIXEL1-3.2, R1-3.2
unnamed: PIXEL1-1.2, R1-1.2
unnamed: PIXEL1-2.2, R1-2.2
unnamed: PIXEL1-4.2, R1-4.2
unnamed: PIXEL2-1.2, R2-1.2
unnamed: PIXEL2-2.2, R2-2.2
unnamed: PIXEL2-3.2, R2-3.2
unnamed: PIXEL2-4.2, R2-4.2
unnamed: PIXEL3-1.2, R3-1.2
unnamed: PIXEL3-2.2, R3-2.2
unnamed: PIXEL3-3.2, R3-3.2
unnamed: PIXEL3-4.2, R3-4.2
unnamed: PIXEL4-1.2, R4-1.2
unnamed: PIXEL4-2.2, R4-2.2
unnamed: PIXEL4-3.2, R4-3.2
unnamed: PIXEL4-4.2, R4-4.2
OUT1-1: ET_CONNECTOR.1, PIXEL1-1.3
OUT1-2: ET_CONNECTOR.2, PIXEL1-2.3
OUT1-3: ET_CONNECTOR.3, PIXEL1-3.3
OUT1-4: ET_CONNECTOR.4, PIXEL1-4.3
OUT2-1: ET_CONNECTOR.5, PIXEL2-1.3
OUT2-2: ET_CONNECTOR.6, PIXEL2-2.3
OUT2-3: ET_CONNECTOR.7, PIXEL2-3.3
OUT2-4: ET_CONNECTOR.8, PIXEL2-4.3
OUT3-1: ET_CONNECTOR.9, PIXEL3-1.3
OUT3-2: ET_CONNECTOR.10, PIXEL3-2.3
OUT3-3: ET_CONNECTOR.11, PIXEL3-3.3
OUT3-4: ET_CONNECTOR.12, PIXEL3-4.3
OUT4-1: ET_CONNECTOR.13, PIXEL4-1.3
OUT4-2: ET_CONNECTOR.14, PIXEL4-2.3
OUT4-3: ET_CONNECTOR.15, PIXEL4-3.3
OUT4-4: ET_CONNECTOR.16, PIXEL4-4.3
SCL: MULTIPLEXER.26 (SCL)
SDA: MULTIPLEXER.27 (SDA)
V+: PIXEL1-1.4, PIXEL1-2.4, PIXEL1-3.4, PIXEL1-4.4, PIXEL2-1.4, PIXEL2-2.4, PIXEL2-3.4, PIXEL2-4.4, PIXEL3-1.4, PIXEL3-2.4, PIXEL3-3.4, PIXEL3-4.4, PIXEL4-1.4, PIXEL4-2.4, PIXEL4-3.4, PIXEL4-4.4
V-: ET_CONNECTOR.17
