MrSwirlyEyes/transmission_of_touch_vr/doc/touch_glove/schematic_et_driver/untitled.sch

## EAGLE design doc/touch_glove/schematic_et_driver/untitled.sch (2019-09-28)

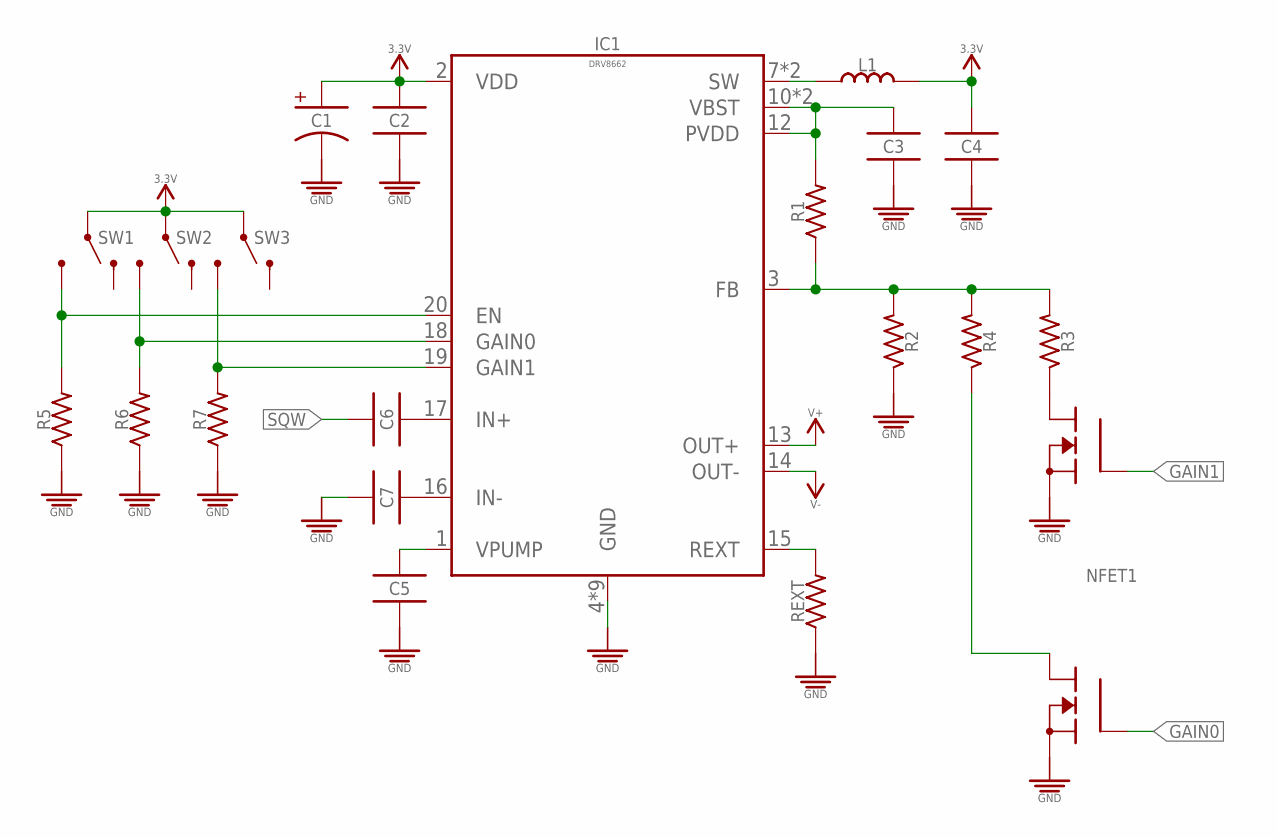
[picture p43: schematic untitled.sch]

Parts:
C1: 100uF/10V; CAPCP3216X160
C2, C5, C6, C7: 0.1uF/50V; CAPC1005X55_SMD-0402
C3: 0.1uF/250V/0805; CAPC2012X95_SMD-0805
C4: 0.1uF/50V; CAPC1608X95
IC1: DRV8662; QFN50P400X400X100-21T270
L1: 4.7uH/2A/1008; INDC2520X100
NFET1: 2N7002DW; SOT65P230X110-6
R1: 768K; RESC1005X35_SMD-0402
R2: 115K; RESC1005X35_SMD-0402
R3: 220K; RESC1005X35_SMD-0402
R4: 100K; RESC1005X35_SMD-0402
R5, R6, R7: 10K; RESC1005X35_SMD-0402
REXT: 7.5K; RESC1005X35_SMD-0402
SW1, SW2, SW3: 300mA/4V; SW_SLIDE_SPDT_RA_SMD_4V_300MA_6.7L-2.6W

Connections:
3.3V: C1.A, C2.1, C4.1, IC1.2 (VDD), L1.2, SW1.2, SW2.2, SW3.2
EN: IC1.20 (EN), R5.2, SW1.3 (S2)
FB: IC1.3 (FB), R1.1, R2.2, R3.2, R4.2
GAIN0: IC1.18 (GAIN0), NFET1.5 (G2), R6.2, SW2.3 (S2)
GAIN1: IC1.19 (GAIN1), NFET1.2 (G1), R7.2, SW3.3 (S2)
GND: C1.K, C2.2, C3.2, C4.2, C5.2, C7.1, IC1.4 (GND), NFET1.1 (S1), NFET1.4 (S2), R2.1, R5.1, R6.1, R7.1, REXT.1
unnamed: IC1.7 (SW), L1.1
unnamed: C5.1, IC1.1 (VPUMP)
unnamed: C3.1, IC1.10 (VBST), IC1.12 (PVDD), R1.2
unnamed: IC1.15 (REXT), REXT.2
unnamed: NFET1.6 (D1), R3.1
unnamed: NFET1.3 (D2), R4.1
unnamed: C6.2, IC1.17 (IN+)
unnamed: C7.2, IC1.16 (IN-)
SQW: C6.1
V+: IC1.13 (OUT+)
V-: IC1.14 (OUT-)
