MrSwirlyEyes/transmission_of_touch_vr/doc/touch_glove/schematic_flex_sensor_driver/schematic_flex_sensor_driver.sch

## EAGLE design doc/touch_glove/schematic_flex_sensor_driver/schematic_flex_sensor_driver.sch (2019-02-06)

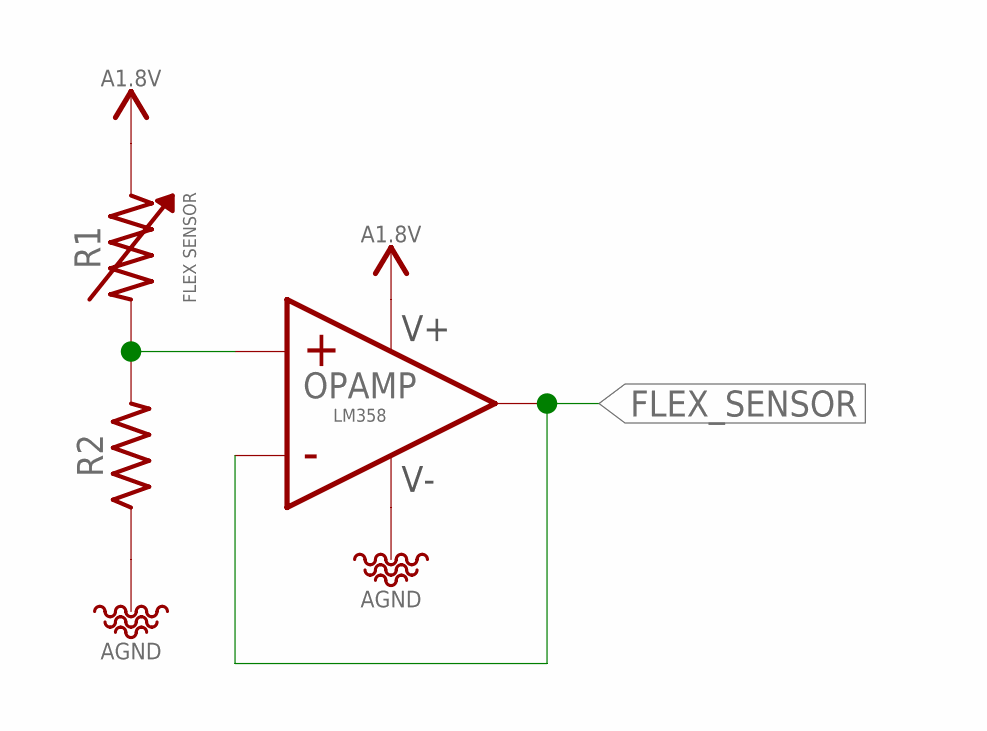
[picture p44: schematic schematic_flex_sensor_driver.sch]

Parts:
OPAMP: OPAMP_ILLUSTRATIVE; SOT95P280X145-5
R1: FLEX SENSOR; PTH-CONNECTOR-2PIN
R2: 10K; RESC1005X35_SMD-0402

Connections:
A1.8V: OPAMP.4 (V+), R1.1
AGND: OPAMP.5 (V-), R2.1
FLEX_SENSOR: OPAMP.2 (IN-), OPAMP.3 (OUT)
unnamed: OPAMP.1 (IN+), R1.2, R2.2

Notes on the sheet:
LM358
