MrSwirlyEyes/transmission_of_touch_vr/doc/touch_glove/schematic_square_wave_oscillator/schematic_square_wave_oscillator.sch

## EAGLE design doc/touch_glove/schematic_square_wave_oscillator/schematic_square_wave_oscillator.sch (2019-04-18)

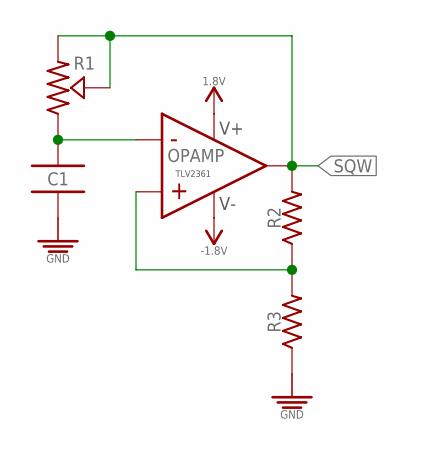
[picture p45: schematic schematic_square_wave_oscillator.sch]

Parts:
C1: 0.1uF/50V; CAPC1005X55_SMD-0402
OPAMP: TLV2361_GP_20MA_7MHZ; SOT95P280X145-5
R1: 100K; POTENTIOMETER_SQ-L5-W4.5-H2.3
R2, R3: 10K; RESC1005X35_SMD-0402

Connections:
1.8V: OPAMP.5 (V+)
-1.8V: OPAMP.2 (V-)
GND: C1.2, R3.1
unnamed: OPAMP.1 (IN+), R2.1, R3.2
unnamed: C1.1, OPAMP.3 (IN-), R1.3 (CW)
SQW: OPAMP.4 (OUT), R1.1 (CCW), R1.2 (S), R2.2

Notes on the sheet:
TLV2361
