MrSwirlyEyes/transmission_of_touch_vr/doc/touch_glove/schematic_thermoelectric_driver/schematic_thermoelectric_driver.sch

## EAGLE design doc/touch_glove/schematic_thermoelectric_driver/schematic_thermoelectric_driver.sch (2019-02-06)

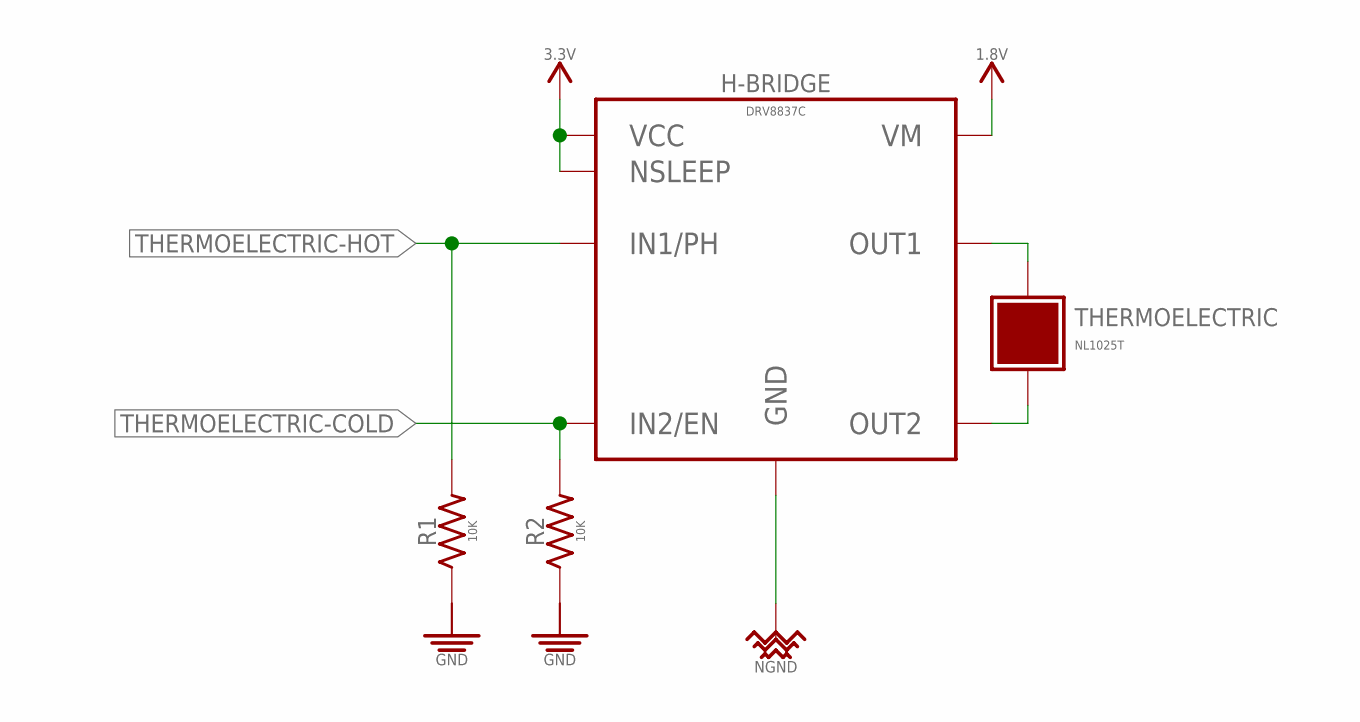
[picture p46: schematic schematic_thermoelectric_driver.sch]

Parts:
H-BRIDGE: DRV8837C; WSON-8-PPAD
R1, R2: 10K; RESC1005X35_SMD-0402
THERMOELECTRIC: NL1025T; _MOLEX-0530470210_VERT_PITCH-1.25MM

Connections:
1.8V: H-BRIDGE.1 (VM)
3.3V: H-BRIDGE.7 (NSLEEP), H-BRIDGE.8 (VCC)
GND: R1.1, R2.1
unnamed: H-BRIDGE.3 (OUT2), THERMOELECTRIC.2 (COLD)
unnamed: H-BRIDGE.2 (OUT1), THERMOELECTRIC.1 (HOT)
NGND: H-BRIDGE.4 (GND)
THERMOELECTRIC-COLD: H-BRIDGE.5 (IN2/EN), R2.2
THERMOELECTRIC-HOT: H-BRIDGE.6 (IN1/PH), R1.2
