MrSwirlyEyes/transmission_of_touch_vr/doc/touch_glove/schematic_vibrotactile_driver/schematic_vibrotactile_driver.sch

## EAGLE design doc/touch_glove/schematic_vibrotactile_driver/schematic_vibrotactile_driver.sch (2019-02-06)

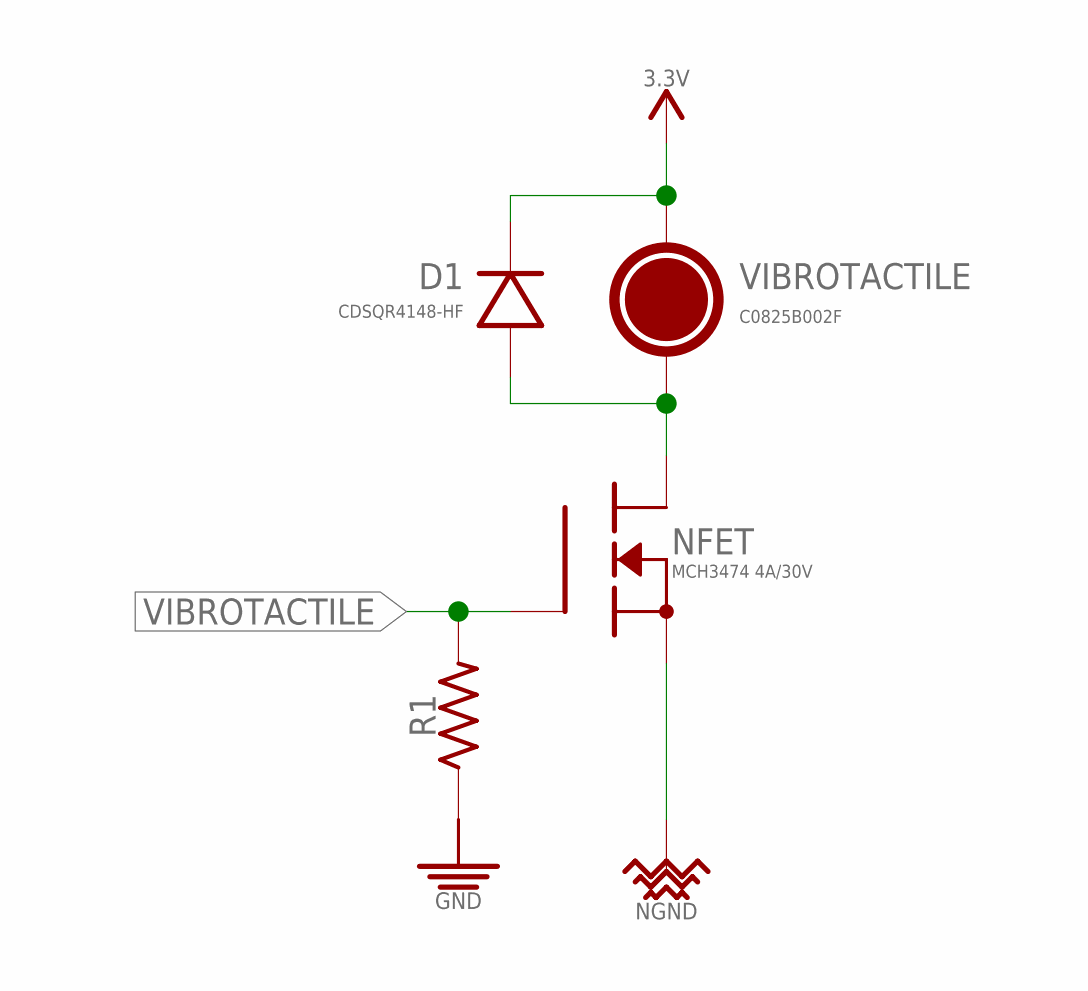
[picture p47: schematic schematic_vibrotactile_driver.sch]

Parts:
D1: CDSQR4148-HF; DFN100X60X55-2
NFET: MCH3474 4A/30V; SOTFL65P209X90-3
R1: 10K; RESC1005X35_SMD-0402
VIBROTACTILE: C0825B002F; _MOLEX-0530470210_VERT_PITCH-1.25MM

Connections:
3.3V: D1.K, VIBROTACTILE.1 (+)
GND: R1.1
unnamed: D1.A, NFET.3 (D), VIBROTACTILE.2 (-)
NGND: NFET.2 (S)
VIBROTACTILE: NFET.1 (G), R1.2
