MrSwirlyEyes/transmission_of_touch_vr/code/tot_vr_robotic_arm_master/tot_vr_robotic_arm_master.ino

#include "radio.h"
#include "CD74HC4067.h"
#include "TMP36.h"
#include "FSR.h"
#include "PCA9685.h"
#include "PCA9685Servo.h"



#define DEBUG

#define RF_CHANNEL 11
#define BAUDRATE 9600



////////////////////////////////
//     ANALOG MULTIPLEXER     //
////////////////////////////////
#define s0 4
#define s1 3
#define s2 6
#define s3 5
#define sig_pin 2

CD74HC4067 multiplexer(s0, s1, s2, s3, sig_pin);



///////////////////////////////////////
//     FORCE SENSITIVE RESISTORS     //
///////////////////////////////////////
#define NUM_FSR 6

#define FSR_PINKY  0
#define FSR_RING   1
#define FSR_MIDDLE 2
#define FSR_INDEX  3
#define FSR_THUMB  4
#define FSR_PALM   5

#define FSR_MIN    0
#define FSR_MAX 4095

#define FSR_MIN_PINKY     0
#define FSR_MIN_RING      0
#define FSR_MIN_MIDDLE    0
#define FSR_MIN_INDEX     0
#define FSR_MIN_THUMB     0
#define FSR_MIN_PALM      0

#define FSR_MAX_PINKY  800 //900 (I physically cannot apply more force than this with my thumb + index)
#define FSR_MAX_RING   800 //900
#define FSR_MAX_MIDDLE 800 //900
#define FSR_MAX_INDEX  800 //900
#define FSR_MAX_THUMB  800 //900
#define FSR_MAX_PALM   800 //900

FSR fsr[NUM_FSR] = {
                      FSR(multiplexer,FSR_PINKY,FSR_MIN_PINKY,FSR_MAX_PINKY,FSR_MIN,FSR_MAX),
                      FSR(multiplexer,FSR_RING,FSR_MIN_RING,FSR_MAX_RING,FSR_MIN,FSR_MAX),
                      FSR(multiplexer,FSR_MIDDLE,FSR_MIN_MIDDLE,FSR_MAX_MIDDLE,FSR_MIN,FSR_MAX),
                      FSR(multiplexer,FSR_INDEX,FSR_MIN_INDEX,FSR_MAX_INDEX,FSR_MIN,FSR_MAX),
                      FSR(multiplexer,FSR_THUMB,FSR_MIN_THUMB,FSR_MAX_THUMB,FSR_MIN,FSR_MAX),
                      FSR(multiplexer,FSR_PALM,FSR_MIN_PALM,FSR_MAX_PALM,FSR_MIN,FSR_MAX),
                    };



/////////////////////////////////
//     TEMPERATURE SENSORS     //
/////////////////////////////////
#define NUM_TEMP 5
#define VCC 1.8

#define TEMP_PINKY  11
#define TEMP_RING   12
#define TEMP_MIDDLE 13
#define TEMP_INDEX  14
#define TEMP_THUMB  15

#define TEC_MAX_HOT 2048
#define TEC_MAX_COLD -4095

#define TEMP_MAX_LIMIT_COLD 12.0
#define TEMP_MIN_LIMIT_COLD 18.0

#define TEMP_MIN_LIMIT_HOT 24.0
#define TEMP_MAX_LIMIT_HOT 30.0

// 32.0 C is approx max I could heat using fingers in ECE Makerspace

byte temp_pin[NUM_TEMP] = {
                            TEMP_PINKY,
                            TEMP_RING,
                            TEMP_MIDDLE,
                            TEMP_INDEX,
                            TEMP_THUMB
                          };

TMP36 temp[NUM_TEMP] = {
                          TMP36(multiplexer,TEMP_PINKY,VCC,TEMP_MIN_LIMIT_COLD,TEMP_MAX_LIMIT_COLD,TEMP_MIN_LIMIT_HOT,TEMP_MAX_LIMIT_HOT,TEC_MAX_COLD,TEC_MAX_HOT),
                          TMP36(multiplexer,TEMP_RING,VCC,TEMP_MIN_LIMIT_COLD,TEMP_MAX_LIMIT_COLD,TEMP_MIN_LIMIT_HOT,TEMP_MAX_LIMIT_HOT,TEC_MAX_COLD,TEC_MAX_HOT),
                          TMP36(multiplexer,TEMP_MIDDLE,VCC,TEMP_MIN_LIMIT_COLD,TEMP_MAX_LIMIT_COLD,TEMP_MIN_LIMIT_HOT,TEMP_MAX_LIMIT_HOT,TEC_MAX_COLD,TEC_MAX_HOT),
                          TMP36(multiplexer,TEMP_INDEX,VCC,TEMP_MIN_LIMIT_COLD,TEMP_MAX_LIMIT_COLD,TEMP_MIN_LIMIT_HOT,TEMP_MAX_LIMIT_HOT,TEC_MAX_COLD,TEC_MAX_HOT),
                          TMP36(multiplexer,TEMP_THUMB,VCC,TEMP_MIN_LIMIT_COLD,TEMP_MAX_LIMIT_COLD,TEMP_MIN_LIMIT_HOT,TEMP_MAX_LIMIT_HOT,TEC_MAX_COLD,TEC_MAX_HOT)
                        };



////////////////////////
//     PWM DRIVER     //
////////////////////////
#define PWM_FREQUENCY 60

PCA9685 pwm_driver = PCA9685();



////////////////////
//     SERVOS     //
////////////////////
#define NUM_SERVO 5

#define SERVO_MIN 0
#define SERVO_MAX 1023

#define SERVO_PINKY   8
#define SERVO_RING    9
#define SERVO_MIDDLE 10
#define SERVO_INDEX  11
#define SERVO_THUMB  12

#define SERVO_MIN_PINKY  180
#define SERVO_MIN_RING   180
#define SERVO_MIN_MIDDLE 180
#define SERVO_MIN_INDEX  180
#define SERVO_MIN_THUMB  180

#define SERVO_MAX_PINKY  450
#define SERVO_MAX_RING   450
#define SERVO_MAX_MIDDLE 450
#define SERVO_MAX_INDEX  450
#define SERVO_MAX_THUMB  450

#define SERVO_MIN_CENTER ((SERVO_MIN_PINKY + SERVO_MIN_RING + SERVO_MIN_MIDDLE + SERVO_MIN_INDEX + SERVO_MIN_THUMB) / NUM_SERVO) //185 (hard settings); 225 (light settings)
#define SERVO_MAX_CENTER ((SERVO_MIN_PINKY + SERVO_MIN_RING + SERVO_MIN_MIDDLE + SERVO_MIN_INDEX + SERVO_MIN_THUMB) / NUM_SERVO) //450 (hard settings); 350 (light settings)
#define SERVO_CENTER ((SERVO_MAX_CENTER + SERVO_MIN_CENTER) / 2)

PCA9685Servo servo[NUM_SERVO] = {
                            PCA9685Servo(pwm_driver,SERVO_PINKY,SERVO_MIN,SERVO_MAX,SERVO_MIN_PINKY,SERVO_MAX_PINKY),
                            PCA9685Servo(pwm_driver,SERVO_RING,SERVO_MIN,SERVO_MAX,SERVO_MIN_RING,SERVO_MAX_RING),
                            PCA9685Servo(pwm_driver,SERVO_MIDDLE,SERVO_MIN,SERVO_MAX,SERVO_MIN_MIDDLE,SERVO_MAX_MIDDLE),
                            PCA9685Servo(pwm_driver,SERVO_INDEX,SERVO_MIN,SERVO_MAX,SERVO_MIN_INDEX,SERVO_MAX_INDEX),
                            PCA9685Servo(pwm_driver,SERVO_THUMB,SERVO_MIN,SERVO_MAX,SERVO_MIN_THUMB,SERVO_MAX_THUMB),
                          };


////////////////////////////
//     COMMUNICATIONS     //
////////////////////////////
struct RoboticArmPacket {    
  int fsr[NUM_FSR] = {0,};
  int temp[NUM_TEMP] = {0,};
  int checksum = 0;
} pkt_tx;

struct TouchGlovePacket {
  int servo[NUM_SERVO] = {0,};
  int checksum = 0;
} pkt_rx;

int checksum = 0;





///////////////////
//     SETUP     //
///////////////////
void setup() {
  #ifdef DEBUG
    Serial.begin(BAUDRATE);
  #endif

  pwm_driver.begin();
  pwm_driver.set_pwm_freq(PWM_FREQUENCY);

  for (int i = 0; i < NUM_SERVO; i++) {
    servo[i].actuate(SERVO_CENTER);
//    servo[i].actuate(SERVO_MAX_PINKY);
  }

  rfBegin(RF_CHANNEL);

  delay(10000);
  test_servo();
  delay(1000);
}



//////////////////
//     LOOP     //
//////////////////
void loop() {

  read_fsr_sensors();
  #ifdef DEBUG
    print_fsr_sensors();
  #endif
  
  read_temp_sensors();
//  #ifdef DEBUG
//    print_temp_sensors();
//  #endif

  pkt_tx.checksum = 0;

  for(int i = 0; i < NUM_FSR; i++) {
    pkt_tx.checksum += pkt_tx.fsr[i];
  }

  for(int i = 0; i < NUM_TEMP; i++) {
    pkt_tx.checksum += pkt_tx.temp[i];
  }
  
  rfWrite((uint8_t *) & pkt_tx,sizeof(RoboticArmPacket));

  #ifdef DEBUG
    print_tx_pkt();
  #endif
  

  if(rfAvailable() >= sizeof(TouchGlovePacket)) {
    rfRead((uint8_t *) & pkt_rx,sizeof(TouchGlovePacket));

    checksum = 0;
    for (int i=0; i < NUM_SERVO; i++) {
      checksum += pkt_rx.servo[i];
    }
    if(checksum == pkt_rx.checksum) {
      #ifdef DEBUG
        print_rx_pkt();
      #endif

      actuate_servos(); 
    } else {
      #ifdef DEBUG
        Serial.println("ERROR");
      #endif
    }
    
    rfFlush();
  }
  delay(3);
}





///////////////////////
//     FUNCTIONS     //
///////////////////////
void read_fsr_sensors() {
  for (int i = 0; i < NUM_FSR; i++) {
    pkt_tx.fsr[i] = fsr[i].read();
  }
}



void read_temp_sensors() {
  for (int i = 0; i < NUM_TEMP; i++) {
    pkt_tx.temp[i] = temp[i].get_tempC_mapped();
  }
}



void actuate_servos() {
  for (int i = 0; i < NUM_SERVO; i++) {
    servo[i].actuate(pkt_rx.servo[i]);
  }
}





//----- TEST FUNCTIONS -----//
void test_servo() {
  for (int j = SERVO_MIN; j < SERVO_MAX; j++) {
    for (int i = 0; i < NUM_SERVO; i++) {  
      servo[i].actuate(j);
    }
    delay(1);
  }
  delay(500);

  for (int j = SERVO_MAX; j > SERVO_MIN; j--) {
    for (int i = 0; i < NUM_SERVO; i++) {  
      servo[i].actuate(j);
    }
    delay(1);
  }
  delay(500);

  for (int i = 0; i < NUM_SERVO; i++) {
    servo[i].actuate(SERVO_CENTER);
  }
  delay(500);
}





//----- PRINT FUNCTIONS -----//
#ifdef DEBUG
  void print_fsr_sensors() {
    Serial.print("TX: (fsr0,fsr1,fsr2,fsr3,fsr4,fsr5)=(");
    for (byte i = 0 ; i < NUM_FSR ; i++) {
      Serial.print(fsr[i].read_raw());
      if (i < NUM_FSR - 1)
        Serial.print(",");
    }  
    Serial.println(")");
  }
  
  void print_temp_sensors() {
      Serial.print("TX: (temp0,temp1,temp2,temp3,temp4)=(");
    for (byte i = 0 ; i < NUM_TEMP ; i++) {
      Serial.print(temp[i].get_tempC());
      if (i < NUM_TEMP - 1)
        Serial.print(",");
    }  
      Serial.println(")");
  }

  void print_tx_pkt() {
//    Serial.print("TX: (fsr_pinky,fsr_ring,fsr_middle,fsr_index,fsr_thumb,temp_pinky,temp_ring,temp_middle,temp_index,temp_thumb)=(");
    Serial.print("TX: (");
    for(int i = 0; i < NUM_FSR; i++) {
      Serial.print(pkt_tx.fsr[i]); Serial.print(",");  
    }
    for(int i = 0; i < NUM_TEMP; i++) {
      Serial.print(pkt_tx.temp[i]); Serial.print(",");  
    }
    
    Serial.print(pkt_tx.checksum); 
    Serial.println(")");
  }
  
  void print_rx_pkt() {
//    Serial.print("RX: (servo_pinky,servo_ring,servo_middle,servo_index,servo_thumb)=(");
    Serial.print("RX: (");
    for(int i = 0; i < NUM_SERVO; i++) {
      Serial.print(pkt_rx.servo[i]); Serial.print(",");      
    }
    Serial.print(pkt_rx.checksum); 
    Serial.println(")");
  }
#endif
