MrSwirlyEyes/transmission_of_touch_vr/code/tot_vr_robotic_arm_master/PCA9585Servo.h

#ifndef _PCA9685SERVO_H
#define _PCA9685SERVO_H

#include "Adafruit_PWMServoDriver.h"

#define PWM_DRIVER_MIN    0
#define PWM_DRIVER_MAX 4095

class PCA9685Servo {
  public:
    PCA9685Servo(Adafruit_PWMServoDriver _pwm_driver,byte _pin,int _min, int _max);

    void actuate(int intensity);

    void off();

    int get_min();

    int get_max();

  private:
    Adafruit_PWMServoDriver _pwm_driver;
    byte _pin;
    int _min;
    int _max;
};

#endif
