MrSwirlyEyes/transmission_of_touch_vr/code/robotic_arm_exp/tot_vr_robotic_arm_master_robo_exp/Vibrotactile.cpp

#include "Vibrotactile.h"

Vibrotactile::Vibrotactile(PCA9685 & _pwm_driver,byte _pin,int _min, int _max) : _pwm_driver(_pwm_driver),_pin(_pin) {
  this->_min = constrain(_min,PWM_DRIVER_MIN,PWM_DRIVER_MAX);
  this->_max = constrain(_max,PWM_DRIVER_MIN,PWM_DRIVER_MAX);
}

void Vibrotactile::actuate(int intensity) {
  this->_pwm_driver.set_pwm(this->_pin,0,constrain(intensity,this->_min,this->_max));
}

int Vibrotactile::get_min() {
  return this->_min;
}

int Vibrotactile::get_max() {
  return this->_max;
}

void Vibrotactile::off() {
  this->_pwm_driver.set_pwm(this->_pin,0,0);
}
