MrSwirlyEyes/transmission_of_touch_vr/code/robotic_arm_exp/tot_vr_robotic_arm_master_robo_exp/PCA9685.h

#ifndef _PCA9685_H
#define _PCA9685_H

#if ARDUINO >= 100
 #include <Arduino.h>
#else
 #include <WProgram.h>
#endif

#include <Wire.h>



#define PCA9685_SUBADR1 0x2
#define PCA9685_SUBADR2 0x3
#define PCA9685_SUBADR3 0x4

#define PCA9685_MODE1 0x0
#define PCA9685_PRESCALE 0xFE

#define LED0_ON_L 0x6
#define LED0_ON_H 0x7
#define LED0_OFF_L 0x8
#define LED0_OFF_H 0x9

#define ALLLED_ON_L 0xFA
#define ALLLED_ON_H 0xFB
#define ALLLED_OFF_L 0xFC
#define ALLLED_OFF_H 0xFD



class PCA9685 {
	public:
		PCA9685(uint8_t _i2c_addr = 0x40);

		void begin(void);
		void reset(void);
		void set_pwm_freq(float freq);
		void set_pwm(uint8_t num, uint16_t on, uint16_t off);

	private:
		uint8_t _i2c_addr;

		TwoWire * _i2c;

		uint8_t read8(uint8_t addr);
		void write8(uint8_t addr, uint8_t d);
};

#endif
