MrSwirlyEyes/transmission_of_touch_vr/code/test_scripts_tg_and_ra/robotic_arm_test_pwm_driver_and_servos/robotic_arm_test_pwm_driver_and_servos.ino

#include "Adafruit_PWMServoDriver.h" //download library from adafruit website

#define NUM_SERVOS 5

#define SERVO_INITIAL 8//8
#define SERVO_FINAL SERVO_INITIAL + NUM_SERVOS

//defined servo values
#define SERVO_MIN  185 //225
#define SERVO_MAX  450 //350 Need another define for wrist servo
#define SERVO_CENTER ((SERVO_MAX + SERVO_MIN) / 2.0)

#define SERVO_DELAY 1

Adafruit_PWMServoDriver pwm = Adafruit_PWMServoDriver();

void setup() {
  Serial.begin(9600);
  Serial.println("start...");
  Serial.println("initializing servos...");
  
  pwm.begin();
  pwm.setPWMFreq(60);

  Serial.println("completed servo initialization...");
  
  for (int i = SERVO_INITIAL; i < SERVO_FINAL; i++) {
    pwm.setPWM(i, 0, SERVO_CENTER);
//    delay(10);
//    pwm.setPWM(i, 0, SERVO_MAX);
  }

  delay(5000);
}

void loop() {
  for (int j = SERVO_MIN; j < SERVO_MAX; j++) {
    for (int i = SERVO_INITIAL; i < SERVO_FINAL; i++) {    
      pwm.setPWM(i, 0, j);
      delay(SERVO_DELAY);
      Serial.println(j);
    }
  }

  delay(1000);

  for (int j = SERVO_MAX; j > SERVO_MIN; j--) {
    for (int i = SERVO_INITIAL; i < SERVO_FINAL; i++) {    
      pwm.setPWM(i, 0, j);
      delay(SERVO_DELAY);
      Serial.println(j);
    }
  }

  delay(1000);
}
