MrSwirlyEyes/transmission_of_touch_vr/code/test_scripts_tg_and_ra/component_test_code/pwm_driver_test_code/pwm_driver_test_code.ino

#include <Wire.h>
#include <Adafruit_PWMServoDriver.h> //library needs to be downloaded

#define SERVOMIN  150 //This is the 'minimum' pulse length count (out of 4096).
#define SERVOMAX  600 //This is the 'maximum' pulse length count (out of 4096).

Adafruit_PWMServoDriver pwm = Adafruit_PWMServoDriver();

int servoNum, angle, i;

//Mux control pins
#define s0 8
#define s1 9
#define s2 10
#define s3 11
//int s0 = 8;
//int s1 = 9;
//int s2 = 10;
//int s3 = 11;

//Mux in "SIG" pin
int SIG_pin = 0;

void setup() 
{
  //Set up serial communication and the number of servos being tested.
  Serial.begin(9600);

  pinMode(s0, OUTPUT);
  pinMode(s1, OUTPUT);
  pinMode(s2, OUTPUT);
  pinMode(s3, OUTPUT);
  
  digitalWrite(s0, LOW);
  digitalWrite(s1, LOW);
  digitalWrite(s2, LOW);
  digitalWrite(s3, LOW); 

  //Set up PWM.
  pwm.begin();
  pwm.setPWMFreq(60);
}

void loop() 
{
  
  //Loop through and read all 16 values
  //Reports back Value at channel 6 is: 346
  for(int i = 0; i < 5; i ++)
  {
    Serial.print("Value at channel ");
    Serial.print(i);
    Serial.print("is : ");
    Serial.println(readMux(i));
    Serial.print("Mapped Value at channel ");
    Serial.print(i);
    Serial.print(" is : ");
    Serial.println(map(readMux(i),70,860,0,180));
    angle = map(readMux(i),0,1000,0,180*4);
    turnTo(i, angle);
  }
  
//  for(int i = 10; i < 15; i ++)
//  {
//    Serial.print("Value at channel ");
//    Serial.print(i);
//    Serial.print("is : ");
//    Serial.println(readMux(i));
//    Serial.print("Mapped Value at channel ");
//    Serial.print(i);
//    Serial.print("is : ");
//    Serial.println(map(readMux(i),700,200,0,180));
//    angle = map(readMux(i),700,200,0,180*4);
//    turnTo(i-5, angle);
//  }
}

void turnTo(int servoNum, int angle)
{
  angle = map(angle, 0, 180*4, SERVOMIN, SERVOMAX);
  pwm.setPWM(servoNum, 0, angle);
}

int readMux(int channel)
{
 int controlPin[] = {s0, s1, s2, s3};

 int muxChannel[16][4]={  {0,0,0,0}, //channel 0
                          {1,0,0,0}, //channel 1
                          {0,1,0,0}, //channel 2
                          {1,1,0,0}, //channel 3
                          {0,0,1,0}, //channel 4
                          {1,0,1,0}, //channel 5
                          {0,1,1,0}, //channel 6
                          {1,1,1,0}, //channel 7
                          {0,0,0,1}, //channel 8
                          {1,0,0,1}, //channel 9
                          {0,1,0,1}, //channel 10
                          {1,1,0,1}, //channel 11
                          {0,0,1,1}, //channel 12
                          {1,0,1,1}, //channel 13
                          {0,1,1,1}, //channel 14
                          {1,1,1,1}  //channel 15   
                 };

  //loop through the 4 sig
  for(int i = 0; i < 4; i ++)
  {
    digitalWrite(controlPin[i], muxChannel[channel][i]);
  }

  //read the value at the SIG pin
  int val = analogRead(SIG_pin);
  
  //return the value
  return val;
}
