MrSwirlyEyes/transmission_of_touch_vr/code/test_scripts_tg_and_ra/component_test_code/RB_test_code/RBRecieve/RBRecieve.ino

#include <radio.h>
#include <Wire.h>
#include <Adafruit_PWMServoDriver.h> //library needs to be downloaded

#define CHANNEL 11
#define SERVOMIN  150 //This is the 'minimum' pulse length count (out of 4096).
#define SERVOMAX  600 //This is the 'maximum' pulse length count (out of 4096).

Adafruit_PWMServoDriver pwm = Adafruit_PWMServoDriver();

Radio radio(CHANNEL);  // Initialize ATmega128RFA1 radio on channel CHANNEL (can be 11-26)

struct Packet {
  int start_check = 0;
  int sensordat[16] = {0,};
  int end_check = 0;
} pkt;

int servoNum, angle, i;

void setup()
{
  Serial.begin(9600);
   //Set up PWM.
  pwm.begin();
  pwm.setPWMFreq(60);
}

void loop()
{
  if(radio.rfAvailable()) {           // If data receievd on radio...
    radio.rfRead((uint8_t *) & pkt,sizeof(Packet)); // ... send it out serial.

    if(valid_pkt_check(pkt)) {
      //Loop through and read all 16 values
      //Reports back Value at channel 6 is: 346
      for(int j = 0; j < 5 ; j++) {
        Serial.print("Raw Flex vall");
        Serial.print(j);
        Serial.print(": ");
        Serial.println(pkt.sensordat[j]);
        angle = map(pkt.sensordat[j],0,1000,0,180);
        turnTo(j, angle);
      }
      for(int j = 5; j<10; j++){
        Serial.print("Raw Pressure vall");
        Serial.print(j-5);
        Serial.print(": ");
        Serial.println(pkt.sensordat[j]);
        angle = map(pkt.sensordat[j],800,200,0,180);
        turnTo(j, angle);
      }
    }
    else { 
      Serial.println("Error");
    }
  }
}

bool valid_pkt_check(Packet & pkt) {
  Serial.print("start_check");
  Serial.println(pkt.start_check,HEX);
  Serial.print("end_check");
  Serial.println(pkt.end_check,HEX);
  if(pkt.start_check != 0xFFFFFEED){
    return false;
  }
  else if(pkt.end_check != 0xFFFFDEAD){
    return false;
  }
  return true;
}

void turnTo(int servoNum, int angle)
{
  angle = map(angle, 0, 180*4, SERVOMIN, SERVOMAX);
  pwm.setPWM(servoNum, 0, angle);
}


  
