MrSwirlyEyes/transmission_of_touch_vr/(commit log)

2017-07-12 Initializing Transmission of Touch VR repo
    [robotic_arm.brd, robotic_arm.sch, touch_glove.brd, touch_glove.sch]
2017-07-17 Added PWM driver and DEMUX to both robotic arm and touch glove. Added some transistors to touch glove
    [robotic_arm.brd, robotic_arm.sch, touch_glove.brd, touch_glove.sch]
2017-07-17 Added vibe motor plus transistor driver arrangement
    [robotic_arm.brd, robotic_arm.sch, touch_glove.brd, touch_glove.sch]
2017-07-18 Added diode and cap to Touch Glove vibe motor drivers
    [touch_glove.brd, touch_glove.sch]
2017-07-18 Added Peltier driving circuitry
    [robotic_arm.brd, robotic_arm.sch, touch_glove.brd, touch_glove.sch]
2017-07-18 Added FSR driver and servo driver for robotic arm
    [robotic_arm.brd, robotic_arm.sch]
2017-08-03 Test code for demux to pwm driver for 10 sensors and actuators
2017-08-04 First upload of testing code for the demux with the RED board. Using 5 flex and 5 force.
    [RedBoardtest.ino]
2017-08-06 Added near-complete MUX code for the Red Board. Added preliminary Red Board data tranmission code. Added preliminary Red Board data recieve code.
2017-08-10 Refined code, got rid of transmitting errors.
    [RBRecieve.ino, RBTransmit.ino]
2017-08-11 Slightly modified RBTransmit. Added test code for temperature sensor TMP36GZ
2017-08-11 Restructured file structure. Added temperature sensor TMP36 library. Added another test code for the TMP36 using the library. Added master ToT folders and dummy files for the actual ToT VR code for T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
2017-08-11 Another small mixtake fixed. Made pin a byte data type to save memory
2017-08-29 Test code for five flex sensors to control five servos on robotic arm using mux
    [analog_demux_test_code.ino, test_code_flex_to_arm.ino]
2017-08-30 wireless working
2017-08-30 Modfied git ignore. Added h bridge files. Modified EAGLE files
    [robotic_arm.brd, robotic_arm.sch, touch_glove.brd, touch_glove.sch]
2017-08-31 Changed print statements for TX and RX
2017-09-02 Modified gitignore. Tons of progress on PCB for Touch Glove
    [touch_glove.brd, touch_glove.sch]
2017-09-03 Added start up sequence for vibe motors. This is to simply for debugging. Have not tested the RF communication part
2017-09-03 Added temperature sensor readings to Robotic Arm code condensedRF version.
2017-09-03 Modified TMP36 temperature sensor library to work with DEMUX. Added ATMEGA128RFA1 and LM9DS1 IMU to Touch Glove schematic
    [touch_glove.brd, touch_glove.sch]
2017-09-03 Added FTDI programmer and AVR SPI bootloader pins to schematic
    [touch_glove.brd, touch_glove.sch]
2017-09-06 Changed power symbols for Glove
    [touch_glove.brd, touch_glove.sch]
2017-09-06 Added Unity Project for Arduino<->Unity communication
2017-09-06 Move Arduino files into project folder within code
    This is the pair-project with the Arduino_Comm_Test found in ../unity. They must be used together to see results.
2017-09-07 Unity to RED board test added. Unity to Arduino test moved. Several changes to Touch Glove sch and brd
    [touch_glove.brd, touch_glove.sch]
2017-09-07 Rev 1 of Touch Glove schematic complete. Putting Touch Glove PCB on hold until Robotic Arm schematic + PCB are done
    [touch_glove.brd, touch_glove.sch]
2017-09-07 Radio wireless communication working! Need to add tuning for TECs
2017-09-08 Rev 1 of Robotic Arm schematic complete
    [robotic_arm.brd, robotic_arm.sch]
2017-09-08 Rev 1: Robotic Arm. Tidied up schematic
    [robotic_arm.sch]
2017-09-08 Rev 1: Robotic Arm. Added reset button to MCU. Modified several of the component symbols. Resized board
    [robotic_arm.brd, robotic_arm.sch]
2017-09-08 Rev 1: Robotic Arm. Initial placement of board complete at (3.30x2.50)in or (83.85x63.50)mm. Might consider putting components on the bottom side of the board
    [robotic_arm.brd, robotic_arm.sch]
2017-09-08 Rev 1: Robotic Arm. Initial placement of board with passive components on bottom side of board 3.20x2.50 inches (81.28x63.50mm)
    [robotic_arm.brd, robotic_arm.sch]
2017-09-09 Rev 1: Robotic Arm. Initial placement of board with passive components on bottom side.
    [robotic_arm.brd, robotic_arm.sch]
2017-09-10 Routed NGND plane + 5V plane + PWM Driver to SERVO sig traces. Routed TEMP and FSR sig pins to DEMUX.
    [robotic_arm.brd, robotic_arm.sch]
2017-09-10 Routed AVCC + AGND power planes
    [robotic_arm.brd, robotic_arm.sch]
2017-09-10 Some more touches to AGND + AVCC power planes
    [robotic_arm.brd]
2017-09-10 Started on immediate power connections
    [robotic_arm.brd, robotic_arm.sch]
2017-09-11 Replaced 2.5V regulator for TECs to 1.8V regulator for TECs. 2.5V got way too hot. But 1.8V can be used effectively
    [touch_glove.brd, touch_glove.sch]
2017-09-11 Moved DEMUX to give some more power plane area.
    [robotic_arm.brd, robotic_arm.sch]
2017-09-11 Routed VBATT and moved MCU regulator for a well-shaped power plane
    [robotic_arm.brd, robotic_arm.sch]
2017-09-11 Routed most of VCC. Rotated PWM Driver to maximize GND plane. Not sure if the amount of work for this was worth it
    [robotic_arm.brd]
2017-09-11 Slight tweaks to last routing of VCC and some of the passive components around it.
    [robotic_arm.brd]
2017-09-11 Fucked up. Forgot pull down and current limiting resistors on PWM driver to servosgit add -A Added them. Need to increase size of board and reroute
    [robotic_arm.brd, robotic_arm.sch]
2017-09-11 Fixed mistake and added the resistors needed for PWM driver and servos. Increased board width, bringing board coast to 1.60. Rerouted PWM driver and servos with respective resistors
    [robotic_arm.brd]
2017-09-12 Slight tweaks to power planes and general routing of top and bottom of the board
    [robotic_arm.brd]
2017-09-12 Added tRestrict under crystal oscillator to reduce any potential noise to device
    [robotic_arm.brd]
2017-09-17 Robotic Arm, Rev 1: Completed all routes. Messy as shit. Much clean up to do
    [robotic_arm.brd, robotic_arm.sch]
2017-11-05 Rev 1: Board complete. Sent to Fab
    [robotic_arm.brd, robotic_arm.sch]
2017-11-18 Modified code to work with new PCB board. Removed libraries, placed in new repo. Finished and printed Robotic Arm PCB board. Tested and WORKS! Started on Touch Glove PCB
    [robotic_arm.brd, robotic_arm.sch, touch_glove.brd, touch_glove.sch]
2017-11-22 Rev 2: Fixed the one baby mistake I found from a via not being connected to GND on the exposed pad under the ATMEGA128RFA1
    [robotic_arm.brd, robotic_arm.sch]
2017-11-25 Started on Touch Glove. Going full ambitious using 0402 for resistors, capacitors, and inductors
    [touch_glove.brd, touch_glove.sch]
2017-11-29 Touch Glove Rev 1: Restarted board. Layout for DEMUX + FLEX sensors completed
    [touch_glove.brd, touch_glove.sch]
2017-11-29 Touch Glove Rev 1: Tested full duplex communication using Robotic Arm PCB. Seems to be working. Flex sensor readings quite wild
    [glove_condensedRF.ino, roboarm_condensedRF.ino]
2017-11-29 Touch Glove Rev 1: Routed Vibe motor, TEC + H Bridge, and PWM Driver
    [touch_glove.brd, touch_glove.sch]
2017-11-29 Touch Glove Rev 1: Resized board. 2.77in in length, under my goal of 3in
    [touch_glove.brd]
2017-12-16 Rev 1 - Touch Glove: Completed. Need to test several pin changes before tape out
    [touch_glove.brd, touch_glove.sch]
2018-01-16 small changes aesthetically
    [touch_glove.sch]
2018-01-31 Rev 1: Touch Glove board ready for fab. Check new pins to strain/flex sensors and confirm working
    [touch_glove.brd]
2018-02-02 Stupid files I had to create b/c OSH Park was being a pain in the ass
    [touch_glove_bullshit.brd, touch_glove_bullshit.sch]
2018-02-25 framerate largely improved by cleaning coroutine and reducing timeout. Arguable difference when removing debug statements.
2018-02-25 model fingers bend in response to flex sensors. I can't map them properly, though...so the hand is doing some creepy ass shit.
2018-02-27 pwm LEDs in response to pressure on an object. However, collisions are buggy, makes LEDs buggy.
2018-03-02 Modify code to work with new PCB. Update components on PCB due to new attributes (DISTLINK) for passive components
    [touch_glove.brd, touch_glove.sch]
2018-03-02 Modify gitignore to ignore eagle.epf. Change folder name from eagle to ecad
    [robotic_arm.brd, robotic_arm.sch, touch_glove.brd, touch_glove.sch, touch_glove_bullshit.brd, touch_glove_bullshit.sch]
2018-03-02 Remove the derp file that OSH Park required
    [touch_glove_bullshit.brd, touch_glove_bullshit.sch]
2018-05-08 Rev 2: Complete transformation. Start by replacing parts with new 3D models and new packages.
    [touch_glove.brd, touch_glove.sch]
2018-05-08 Several more replacements and moved parts such that they are snapped to the grid.
    [touch_glove.brd, touch_glove.sch]
2018-05-12 Start and complete much of the 4 layer routing. All components on board have 3D models.
    [touch_glove.brd, touch_glove.sch]
2018-05-15 Add option to use two different analog voltages.
    [touch_glove.brd, touch_glove.sch]
2018-05-15 Replaced Robotic Arm components for those with 3D models. Also went down to 0402 component size.
    [robotic_arm.brd, robotic_arm.sch, touch_glove.brd, touch_glove.sch]
2018-07-09 Rev 2: Touch Glove. Add op amps to flex sensor set 2.
    [touch_glove.brd, touch_glove.sch]
2018-07-09 Replaced supply devices from a non-existent library.
    [touch_glove.brd, touch_glove.sch]
2018-07-09 Rev 2: Touch Glove. Updated library meta data to reflect item availability. Add 3D STEP file.
    [touch_glove.brd, touch_glove.sch]
2018-07-31 Update libraries.
    [touch_glove.brd]
2018-09-03 Add several test codes for PCB.
    [touch_glove.brd, touch_glove.sch]
2018-09-03 most recent arduino code for communicating glove to unity
2018-09-03 comment out PWM driver in unity_to_glove so we can test flex
    [touch_glove.sch]
2018-09-04 vibes and flex working on glove
    [Unity_Comm_Test.ino]
2018-09-23 Massive updates to code. Changed touch glove PCB to Rev 3 with 1.8V regulator, confirmed to work.
    [touch_glove.brd, touch_glove.sch]
2018-10-05 Start on Rev 2 of robotic arm. Made minor fixes to Touch Glove Rev 2.
    [robotic_arm.brd, robotic_arm.sch, touch_glove.brd, touch_glove.sch]
2018-10-06 Testing repo link.
    [robotic_arm.brd]
2018-10-15 Robotic Arm Rev 2: Complete ToT VR Robo Arm Rev 2. Ready for fab.
    [robotic_arm.brd, robotic_arm.sch]
2018-11-02 Rev 3: Robotic Arm. Fix mistake with A3.3V not connected to ATMEGA128RFA1 EVDD (pin 59) which may be affecting the bootload process.
    [robotic_arm.brd, robotic_arm.sch, touch_glove.sch]
2018-11-03 Updated aesthetics of robotic arm board. Changed orientation.
    [robotic_arm.brd, robotic_arm.sch]
2018-11-14 Rev 3: Changes to robotic and and touch glove to fix inconsistencies and errors from Rev 2.
    [robotic_arm.brd, robotic_arm.sch, touch_glove.brd, touch_glove.sch]
2018-11-14 A song of Ice and Fire -- mostly fire. Touch Glove and Robotic Arm seem to be working as expected including flex sensors, vibe motors, and TECs.
    [robotic_arm_test_cd74hc4067_and_pressure_sensors.ino, robotic_arm_test_cd74hc4067_and_tmp36_temp_sensors.ino, robotic_arm_test_pwm_driver_and_servos.ino, test_radio_communication.ino, tot_vr_robotic_arm_master.ino, tot_vr_touch_glove_master.ino, touch_glove_test_cd74hc4067_and_flex_sensors.ino, touch_glove_test_flex_sensors_and_vibrotactiles.ino]
2019-01-26 Update all components to new libraries.
    [touch_glove.brd, touch_glove.sch]
2019-01-26 Fix all errors on board.
    [touch_glove.brd, touch_glove.sch]
2019-01-27 Completed most of the circuitry for the ET schematic.
    [touch_glove.brd, touch_glove.sch]
2019-01-27 Removed the 5 extra flex sensors. Added the 4 headers that will connect to the ET extension board.
    [touch_glove.brd, touch_glove.sch]
2019-01-27 Create Electrotactile Extension board.
    [electrotactile_extension.brd, electrotactile_extension.sch]
2019-02-06 Update work on Electrotactile extension board. Add doc folder with several schematics breaking down the transmission of touch for documentation purposes.
    [electrotactile_extension.brd, electrotactile_extension.sch, schematic_flex_sensor_driver.sch, schematic_force_sensitive_resistor_driver.sch, schematic_servo_driver.sch, schematic_temperature_sensor_driver.sch, schematic_thermoelectric_driver.sch, schematic_vibrotactile_driver.sch]
2019-02-06 Update Robotic Arm to use new EAGLE library names.
    [robotic_arm.brd, robotic_arm.sch]
2019-02-06 Remove components that I believe are unecessary or redundant.
    [robotic_arm.brd, robotic_arm.sch]
2019-03-03 Update for heat and direction readings. Needs pins
2019-03-03 Create mcu to unity example code. Create schematics for master thesis. Edit robotic arm and touch glove pcb.
    [robotic_arm.brd, robotic_arm.sch, schematic_servo_driver.sch, touch_glove.brd, touch_glove.sch]
2019-03-03 Changed folder structure to put all tg and ra test scripts in a folder (junk folder) and all unity test scripts in a folder (junk folder). Inside code now has these two 'junk' folders and the 3 main 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
2019-03-03 Clean up robotic arm code and touch glove code.
2019-03-04 Create FSR/Flex class and Vibrotactile class and made the appropriate changes in TG and RA. Tested in TG only so far (and works). NEed to test RA.
    [FSR.cpp, FSR.h, Vibrotactile.cpp, Vibrotactile.h, tot_vr_robotic_arm_master.ino, tot_vr_touch_glove_master.ino]
2019-03-05 Create PCA9685Servo library. Update robotic arm PCB to Rev 3. Ready for fab.
    [robotic_arm.brd, robotic_arm.sch]
2019-03-09 Create PCA9685Servo library. Touch up Touch Glove PCB. Major work completed on ET Extension.
    [electrotactile_extension.brd, electrotactile_extension.sch, touch_glove.brd, touch_glove.sch]
2019-03-10 Autocalibrate...not there yet. Fixed other stuff tho?:
    [tot_vr_unity_touch_glove_master.ino]
2019-03-10 calibration wooooooooooorks! I needs to turn int into long - overflow. Middle finger vibrotactile is suspect.
2019-03-11 FSR, Thermo, and Vibro all work! Except for the middle finger vibe...
2019-03-12 Complete iteration of ET Extension and Touch Glove. Verify PCA9685Servo library works and made appropriate changes in robotic arm master code.
    [electrotactile_extension.brd, electrotactile_extension.sch, touch_glove.brd, touch_glove.sch]
2019-03-12 Create PCA9685 library that is a slightly modified Adafruit PWM Driver library.
2019-03-12 Replace Adafruit library with custom library.
    [tot_vr_unity_touch_glove_master.ino]
2019-03-12 Remove Adafruit PWM library.
2019-03-12 Fix sizing of some text on board. Clean up schematic.
    [touch_glove.brd, touch_glove.sch]
2019-03-12 Moved some text on the robotic arm board.
    [robotic_arm.brd]
2019-04-06 Lots of changes. But rip.
    [electrotactile_extension.brd, electrotactile_extension.sch, robotic_arm.brd, robotic_arm.sch, touch_glove.brd, touch_glove.sch]
2019-04-18 Everything fucking works (have not tested ET driver extensively yet though)
    [electrotactile_extension.brd, electrotactile_extension.sch, robotic_arm.brd, robotic_arm.sch, schematic_square_wave_oscillator.sch, touch_glove.brd, touch_glove.sch]
2019-04-24 Add thermoelectric stuff.
    [electrotactile_extension.brd]
2019-05-15 Wednesday 5/15/2019 Lipomi trial
2019-05-16 Updates. Meep.
    [electrotactile_extension.brd, electrotactile_extension.sch]
